alkaliu/CanLogger2CH_stm32/doc/protect_12v.png

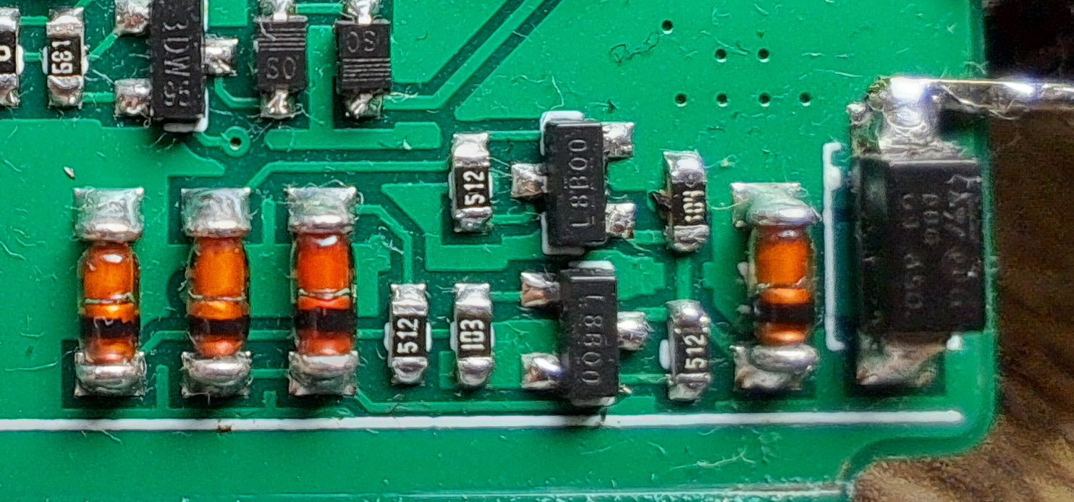
doc/protect_12v.png
