alkaliu/CanLogger2CH_stm32/doc/ap63205.png

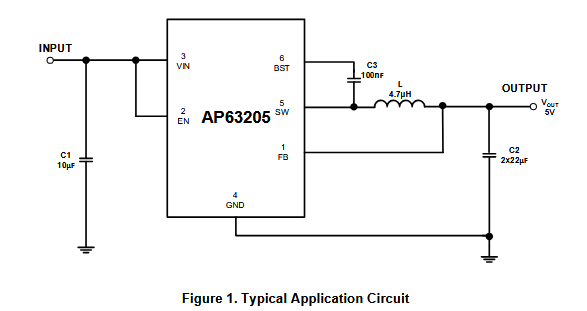
doc/ap63205.png
