alkaliu/CanLogger2CH_stm32/doc/STDC14.png

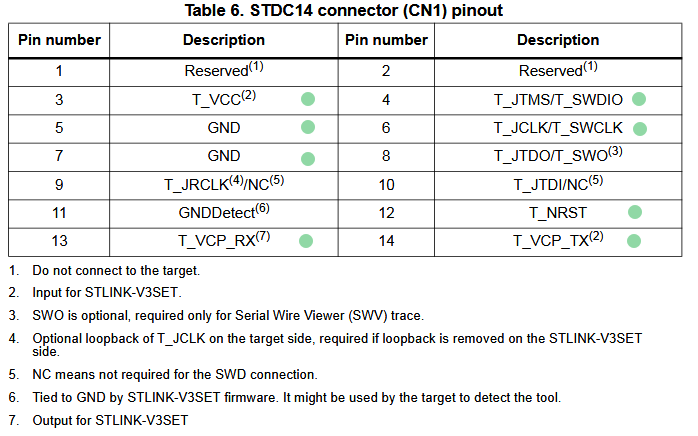
doc/STDC14.png
