alkaliu/CanLogger2CH_stm32/sch/EASYEDA_MODELS/FTSH-107-01-F-DV--3DModel-STEP-56544.STEP

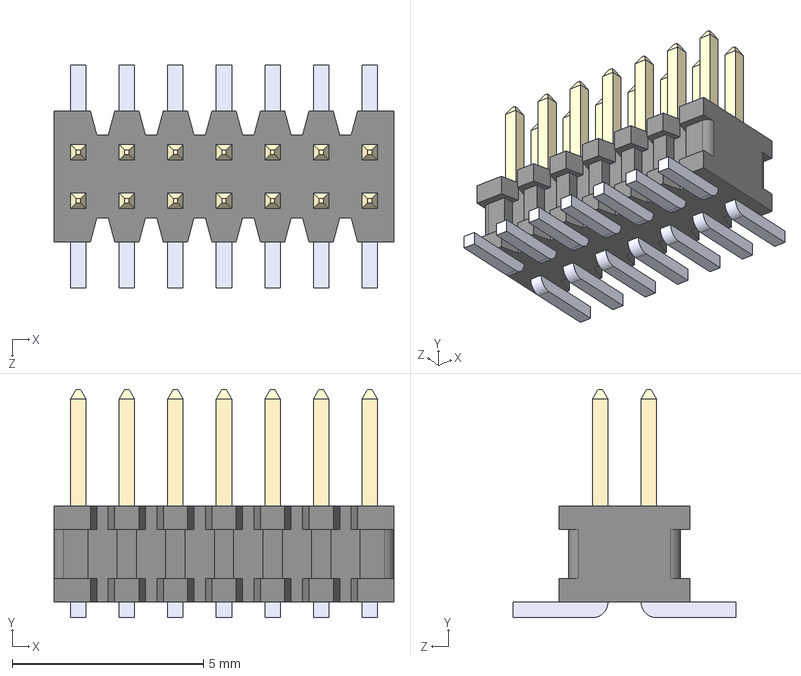
[picture p4: CAD file, 2025-10-31]
sch/EASYEDA_MODELS/FTSH-107-01-F-DV--3DModel-STEP-56544.STEP
8.89 x 5.97 x 5.84 mm
