alkaliu/CanLogger2CH_stm32/sch/EASYEDA_MODELS/CASE-A_3216.step

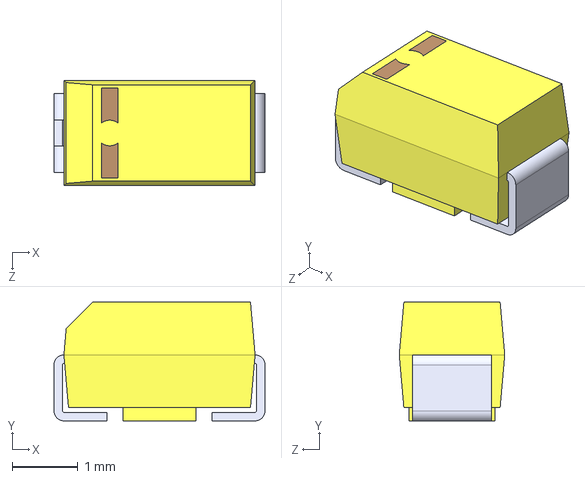
[picture p5: CAD file, 2025-10-31]
sch/EASYEDA_MODELS/CASE-A_3216.step
3.20 x 1.80 x 1.60 mm
