alkaliu/CanLogger2CH_stm32/sch/EASYEDA_MODELS/HDR2.54-M-LI-2x3P.step

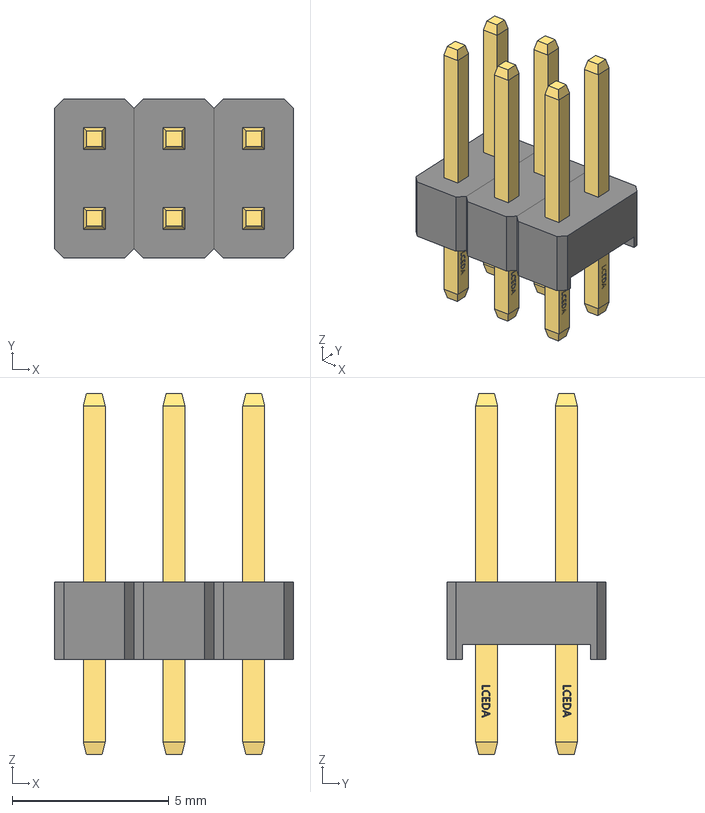
[picture p7: CAD file, 2025-10-31]
sch/EASYEDA_MODELS/HDR2.54-M-LI-2x3P.step
7.62 x 5.08 x 11.5 mm
