alkaliu/CanLogger2CH_stm32/sch/EASYEDA_MODELS/SMA_L4.3-W2.6-LS5.2-RD.step

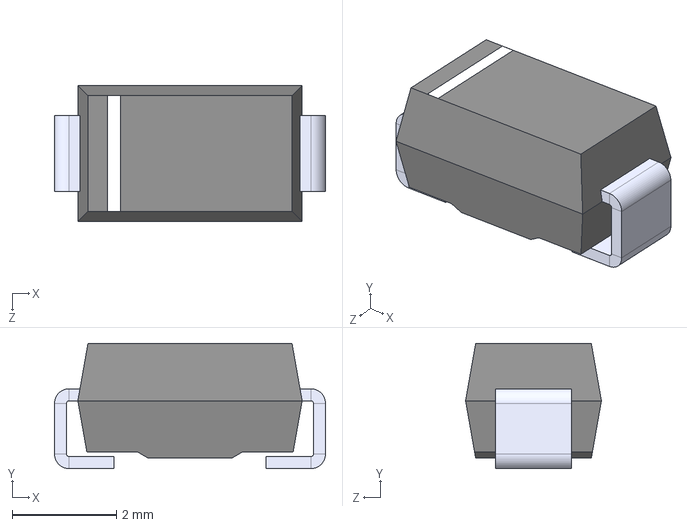
[picture p8: CAD file, 2025-10-31]
sch/EASYEDA_MODELS/SMA_L4.3-W2.6-LS5.2-RD.step
5.20 x 2.40 x 2.60 mm
