alkaliu/CanLogger2CH_stm32/sch/EASYEDA_MODELS/DLW31SN222SQ2L--3DModel-STEP-1.STEP

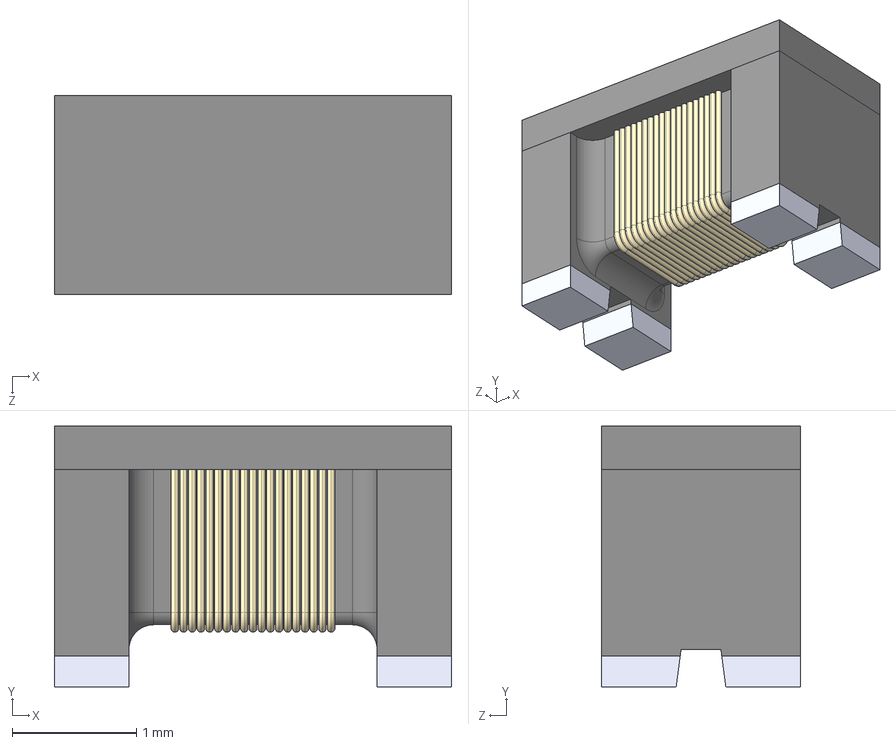
[picture p9: CAD file, 2025-10-31]
sch/EASYEDA_MODELS/DLW31SN222SQ2L--3DModel-STEP-1.STEP
3.20 x 2.10 x 1.60 mm
