alkaliu/CanLogger2CH_stm32/sch/EASYEDA_MODELS/C1206_L3.2-W1.6-H1.3.step

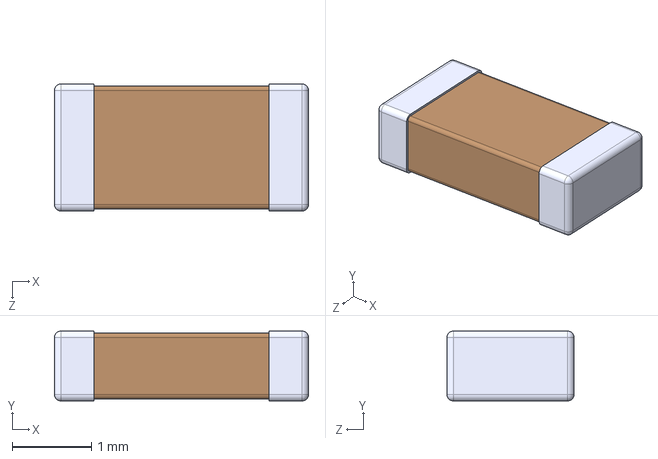
[picture p10: CAD file, 2025-10-31]
sch/EASYEDA_MODELS/C1206_L3.2-W1.6-H1.3.step
3.20 x 0.88 x 1.60 mm
