alkaliu/CanLogger2CH_stm32/sch/EASYEDA_MODELS/USB-C-SMD_GT-USB-7047A.step

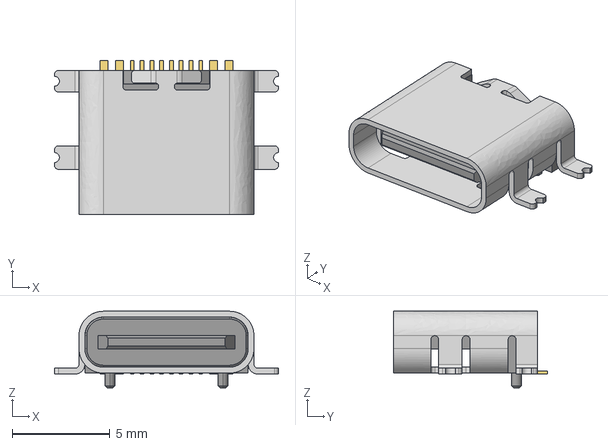
[picture p11: CAD file, 2025-10-31]
sch/EASYEDA_MODELS/USB-C-SMD_GT-USB-7047A.step
11.4 x 7.85 x 3.91 mm
