alkaliu/CanLogger2CH_stm32/sch/EASYEDA_MODELS/C0603_L1.6-W0.8-H0.8.step

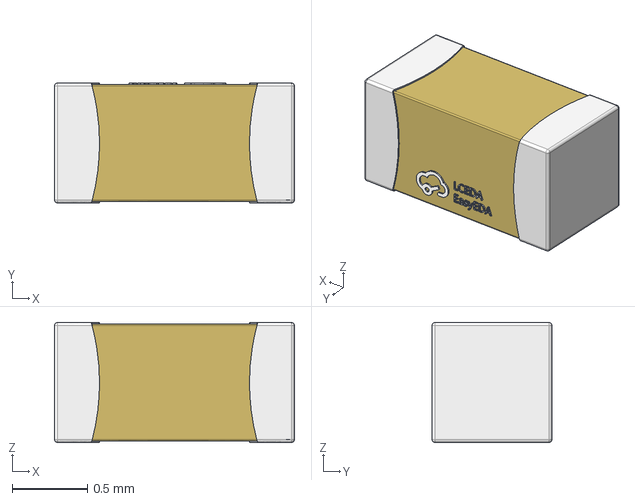
[picture p12: CAD file, 2025-10-31]
sch/EASYEDA_MODELS/C0603_L1.6-W0.8-H0.8.step
1.60 x 0.8 x 0.8 mm
