alkaliu/CanLogger2CH_stm32/sch/EASYEDA_MODELS/LED0603-RD.step

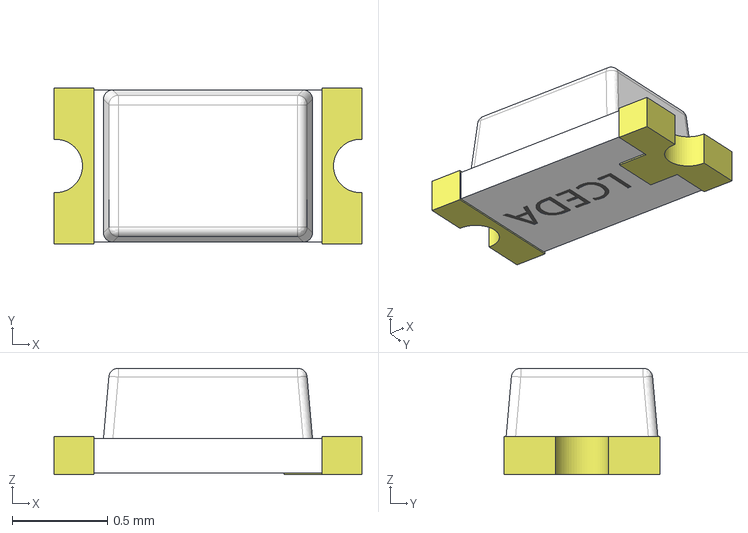
[picture p13: CAD file, 2025-10-31]
sch/EASYEDA_MODELS/LED0603-RD.step
1.62 x 0.82 x 0.56 mm
