alkaliu/CanLogger2CH_stm32/sch/EASYEDA_MODELS/F1812_L4.5-W3.2-H1.0.step

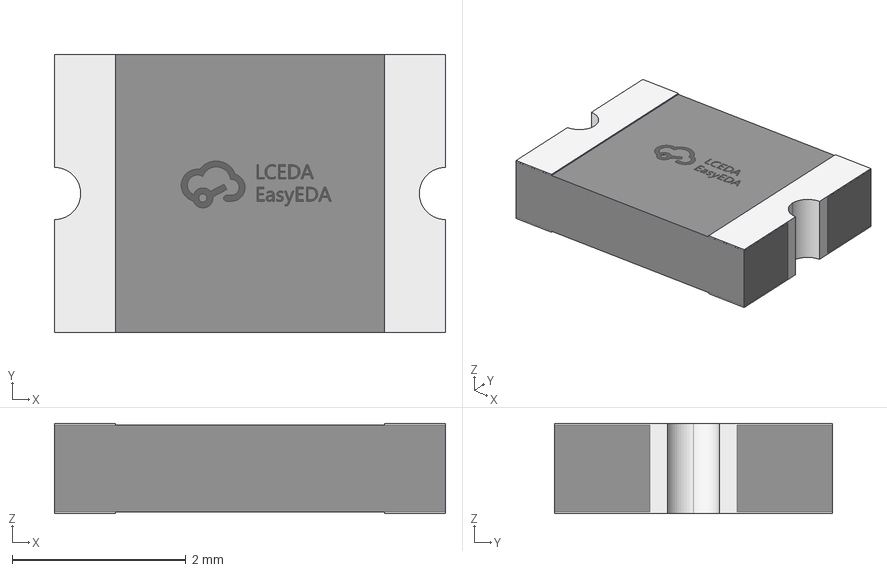
[picture p14: CAD file, 2025-10-31]
sch/EASYEDA_MODELS/F1812_L4.5-W3.2-H1.0.step
4.50 x 3.20 x 1.04 mm
