alkaliu/CanLogger2CH_stm32/sch/EASYEDA_MODELS/SW-SMD_L5.2-W5.2-H4.5-P3.70-LS6.4.step

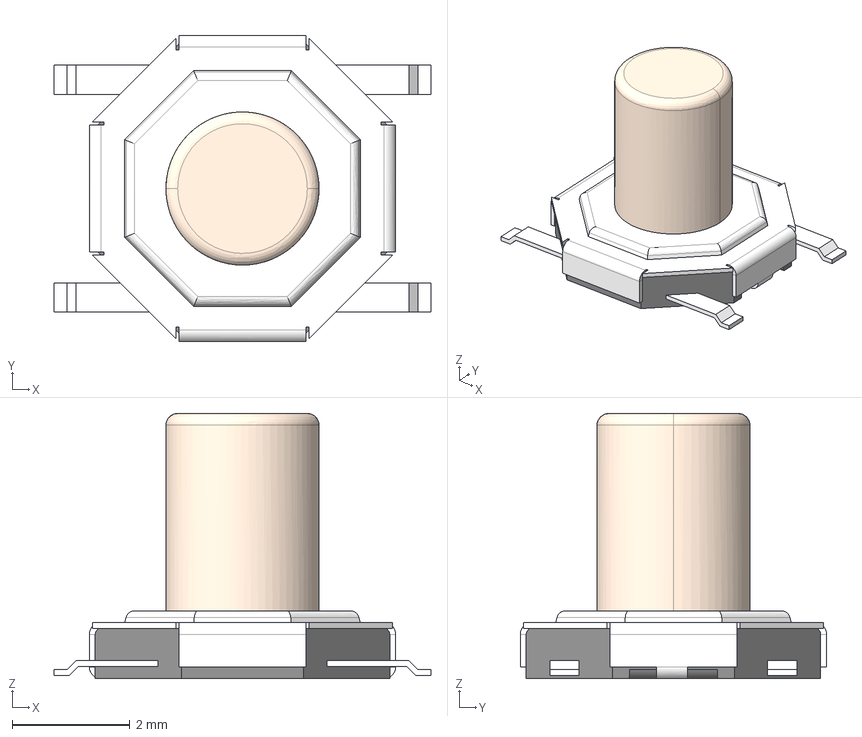
[picture p15: CAD file, 2025-10-31]
sch/EASYEDA_MODELS/SW-SMD_L5.2-W5.2-H4.5-P3.70-LS6.4.step
6.40 x 5.20 x 4.50 mm
