alkaliu/CanLogger2CH_stm32/sch/EASYEDA_MODELS/FILTER-SMD_4P-L3.2-W1.6-H1.9-BL_DLW31SN222SQ2L.step

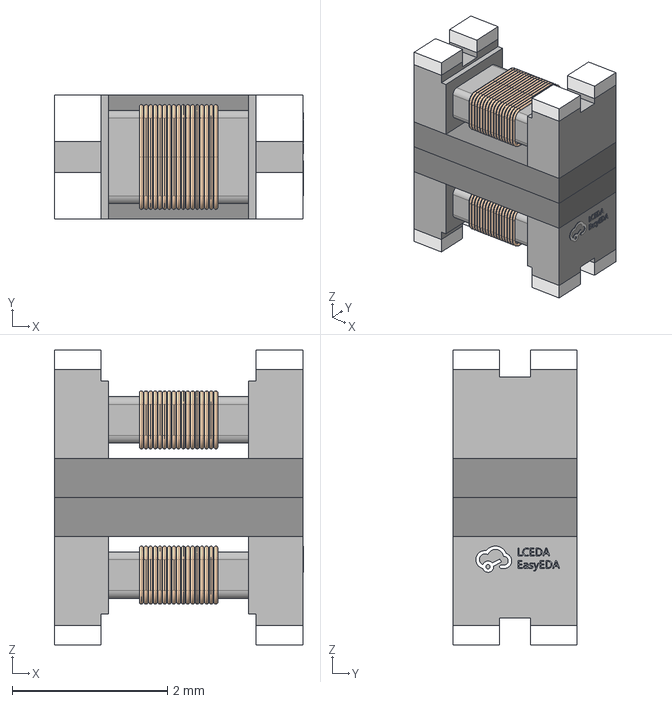
[picture p16: CAD file, 2025-10-31]
sch/EASYEDA_MODELS/FILTER-SMD_4P-L3.2-W1.6-H1.9-BL_DLW31SN222SQ2L.step
3.21 x 1.60 x 3.80 mm
