alkaliu/CanLogger2CH_stm32/sch/EASYEDA_MODELS/SOT-323-3_L2.0-W1.3-H1.0-LS2.1-P1.30.step

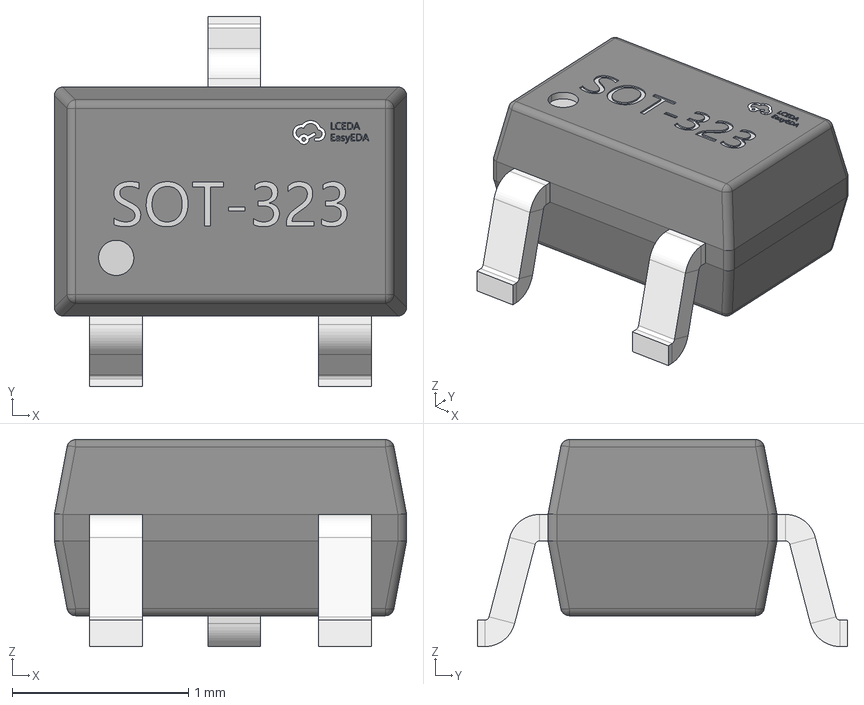
[picture p17: CAD file, 2025-10-31]
sch/EASYEDA_MODELS/SOT-323-3_L2.0-W1.3-H1.0-LS2.1-P1.30.step
2.00 x 2.10 x 1.18 mm
