alkaliu/CanLogger2CH_stm32/sch/EASYEDA_MODELS/SOT-23-3L_L2.9-W1.6-H1.1-LS2.8-P0.95.step

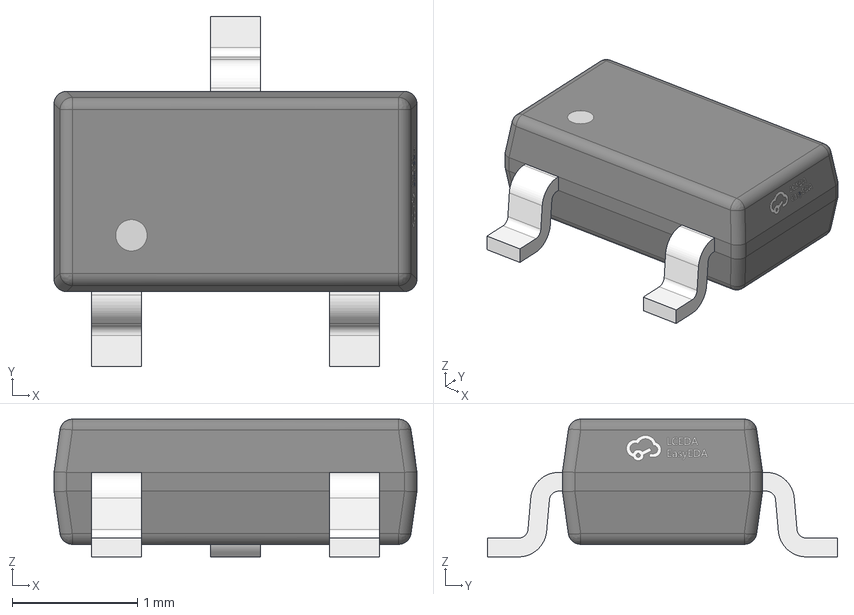
[picture p18: CAD file, 2025-10-31]
sch/EASYEDA_MODELS/SOT-23-3L_L2.9-W1.6-H1.1-LS2.8-P0.95.step
2.90 x 2.80 x 1.10 mm
