alkaliu/CanLogger2CH_stm32/sch/EASYEDA_MODELS/CRYSTAL-SMD_4P-L3.2-W2.5-BL_SIT8008BI.step

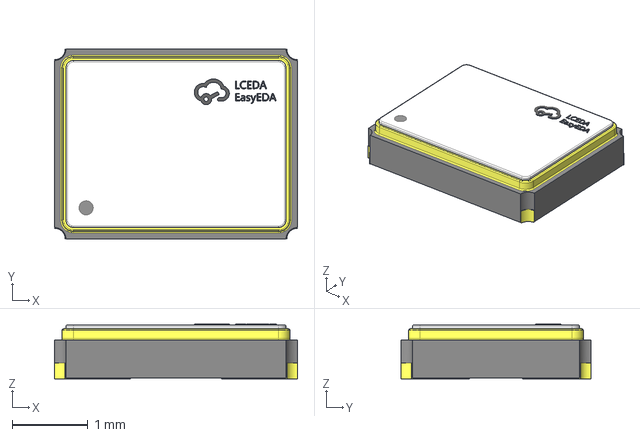
[picture p19: CAD file, 2025-10-31]
sch/EASYEDA_MODELS/CRYSTAL-SMD_4P-L3.2-W2.5-BL_SIT8008BI.step
3.20 x 2.50 x 0.72 mm
