alkaliu/CanLogger2CH_stm32/sch/EASYEDA_MODELS/IND-SMD_L4.4-W4.2-H1.2_PSPMAA0412.step

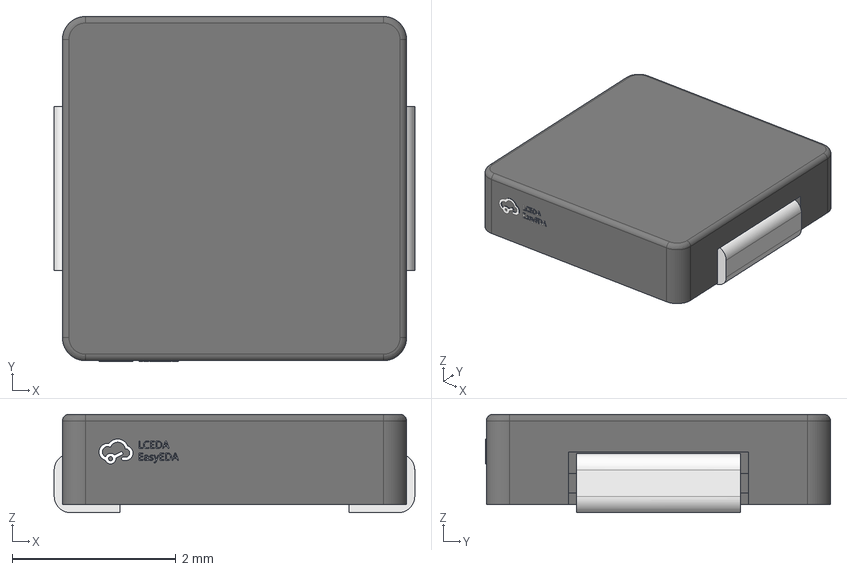
[picture p21: CAD file, 2025-10-31]
sch/EASYEDA_MODELS/IND-SMD_L4.4-W4.2-H1.2_PSPMAA0412.step
4.40 x 4.21 x 1.20 mm
