alkaliu/CanLogger2CH_stm32/sch/EASYEDA_MODELS/LED0805-RD_GREEN.step

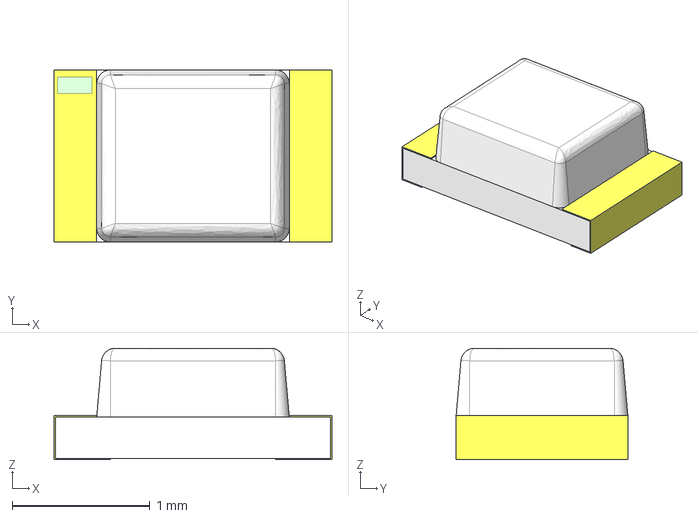
[picture p22: CAD file, 2025-10-31]
sch/EASYEDA_MODELS/LED0805-RD_GREEN.step
2.02 x 1.25 x 0.81 mm
