alkaliu/CanLogger2CH_stm32/sch/EASYEDA_MODELS/SMA_L4.4-W2.6-LS5.0-RD.step

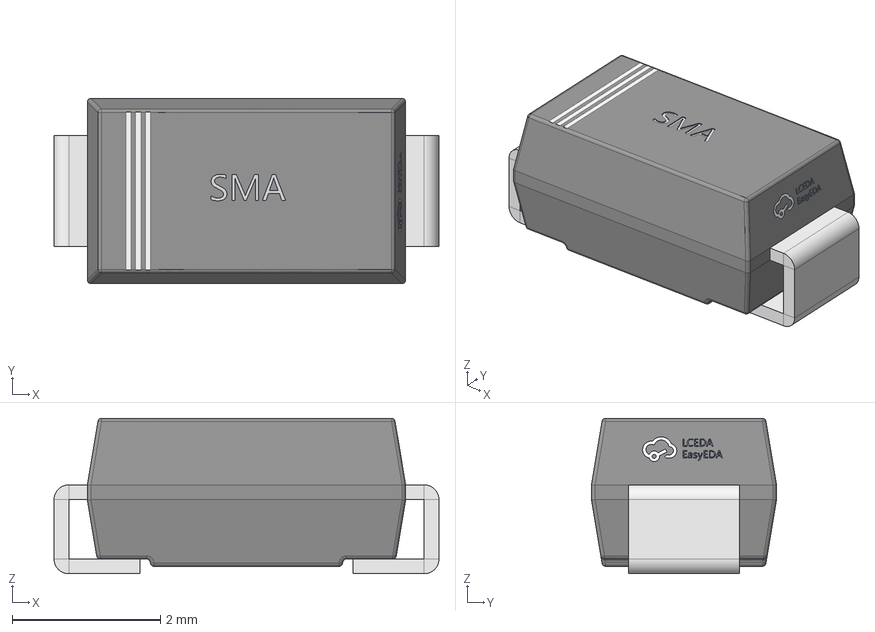
[picture p23: CAD file, 2025-10-31]
sch/EASYEDA_MODELS/SMA_L4.4-W2.6-LS5.0-RD.step
5.20 x 2.50 x 2.10 mm
