alkaliu/CanLogger2CH_stm32/sch/EASYEDA_MODELS/C0805_L2.0-W1.3-H1.3.step

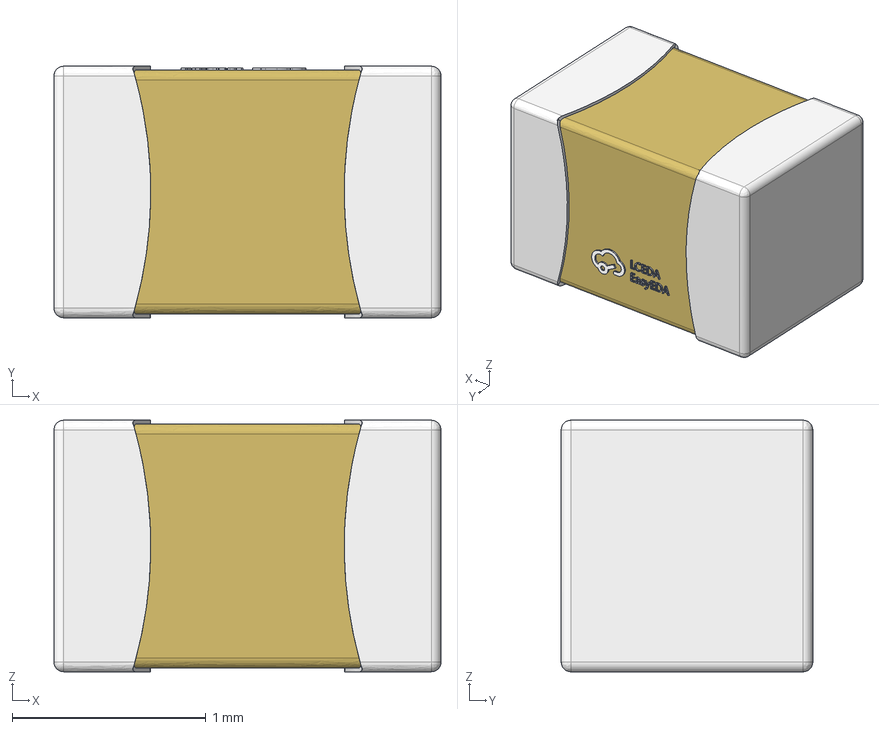
[picture p24: CAD file, 2025-10-31]
sch/EASYEDA_MODELS/C0805_L2.0-W1.3-H1.3.step
2.00 x 1.30 x 1.30 mm
