alkaliu/CanLogger2CH_stm32/sch/EASYEDA_MODELS/DSUB-TH_DMR-9P-M-LI.step

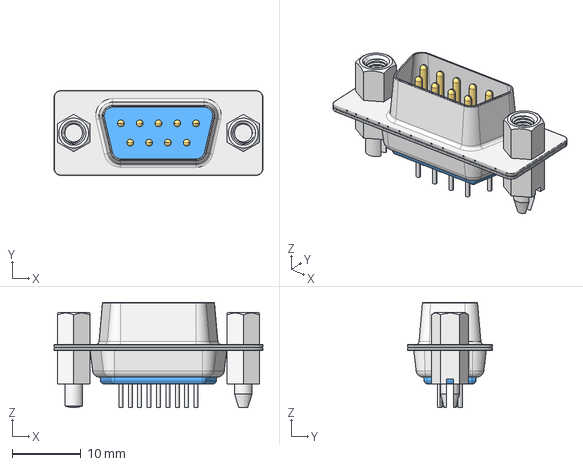
[picture p26: CAD file, 2025-10-31]
sch/EASYEDA_MODELS/DSUB-TH_DMR-9P-M-LI.step
30.4 x 12.3 x 15.3 mm
