alkaliu/CanLogger2CH_stm32/sch/EASYEDA_MODELS/USB-C-SMD_GT-USB-7010C.step

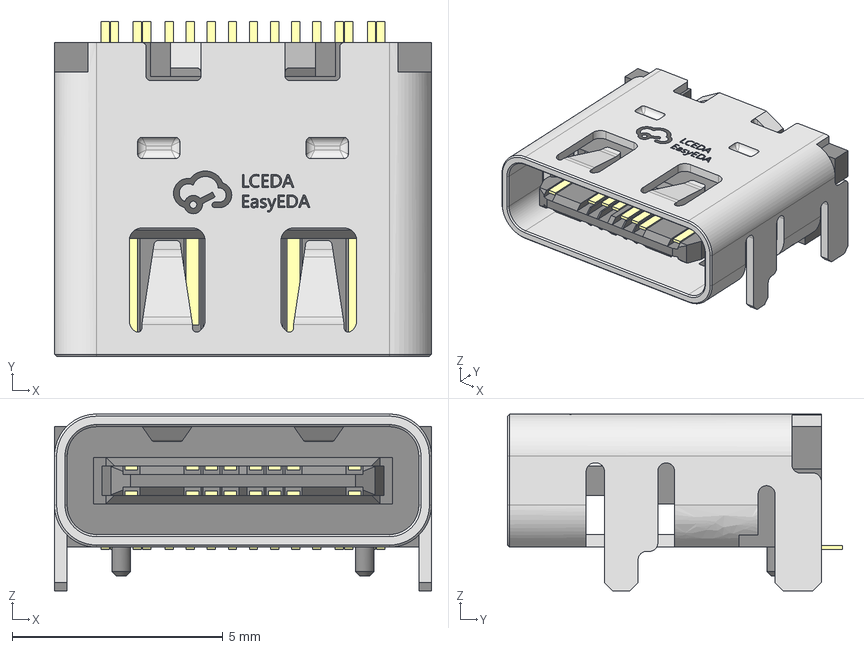
[picture p27: CAD file, 2025-10-31]
sch/EASYEDA_MODELS/USB-C-SMD_GT-USB-7010C.step
8.95 x 7.95 x 4.20 mm
