alkaliu/CanLogger2CH_stm32/sch/EASYEDA_MODELS/R1206_L3.2-W1.6-H0.6.step

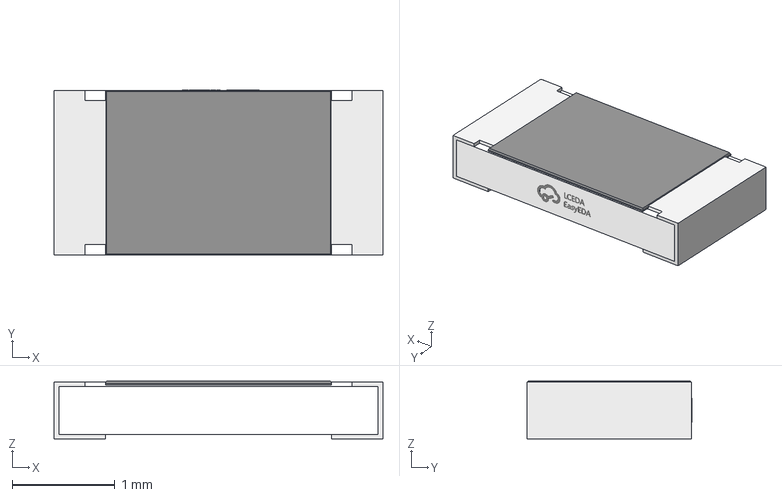
[picture p28: CAD file, 2025-10-31]
sch/EASYEDA_MODELS/R1206_L3.2-W1.6-H0.6.step
3.20 x 1.60 x 0.56 mm
