alkaliu/CanLogger2CH_stm32/sch/EASYEDA_MODELS/SOT-23-3P_L2.9-W1.3-H1.0-LS2.4-P0.95.step

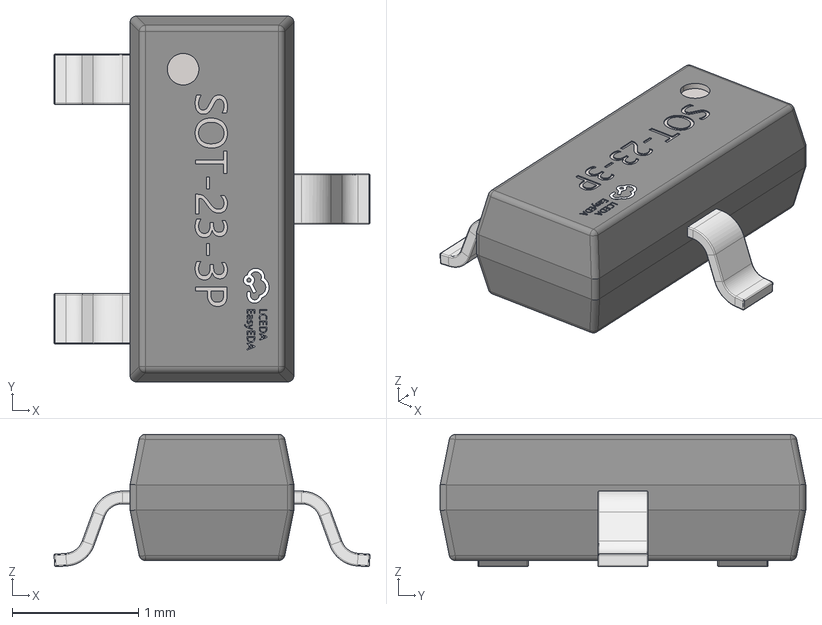
[picture p29: CAD file, 2025-10-31]
sch/EASYEDA_MODELS/SOT-23-3P_L2.9-W1.3-H1.0-LS2.4-P0.95.step
2.51 x 2.90 x 1.05 mm
