alkaliu/CanLogger2CH_stm32/sch/EASYEDA_MODELS/SOD-323_L1.8-W1.3-LS2.5-RD.step

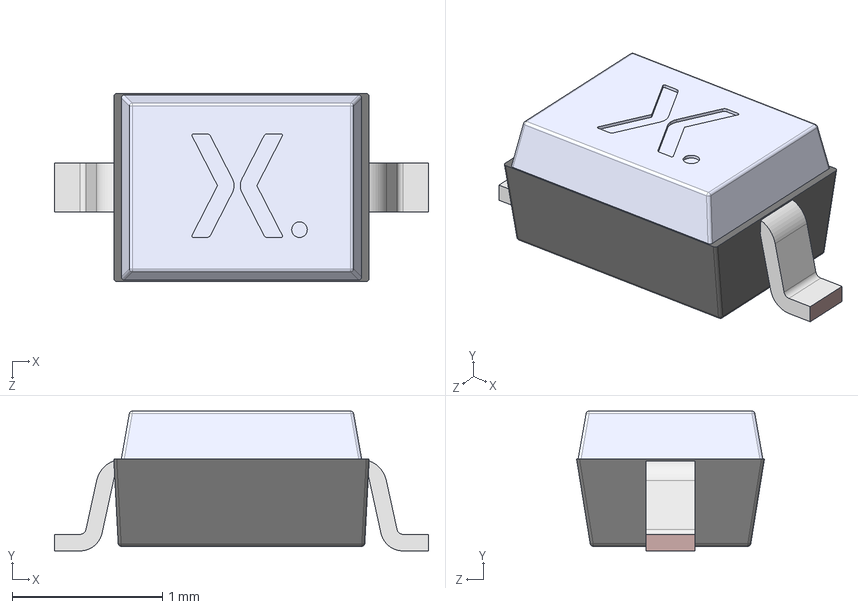
[picture p30: CAD file, 2025-10-31]
sch/EASYEDA_MODELS/SOD-323_L1.8-W1.3-LS2.5-RD.step
2.49 x 0.93 x 1.25 mm
SOD323 Lower body
SOD323 Lead x 2
SOD323 Upper body
