alkaliu/CanLogger2CH_stm32/sch/EASYEDA_MODELS/TO-252-2L-3P_L6.6-W6.1-H2.3-LS10.1-P4.6.step

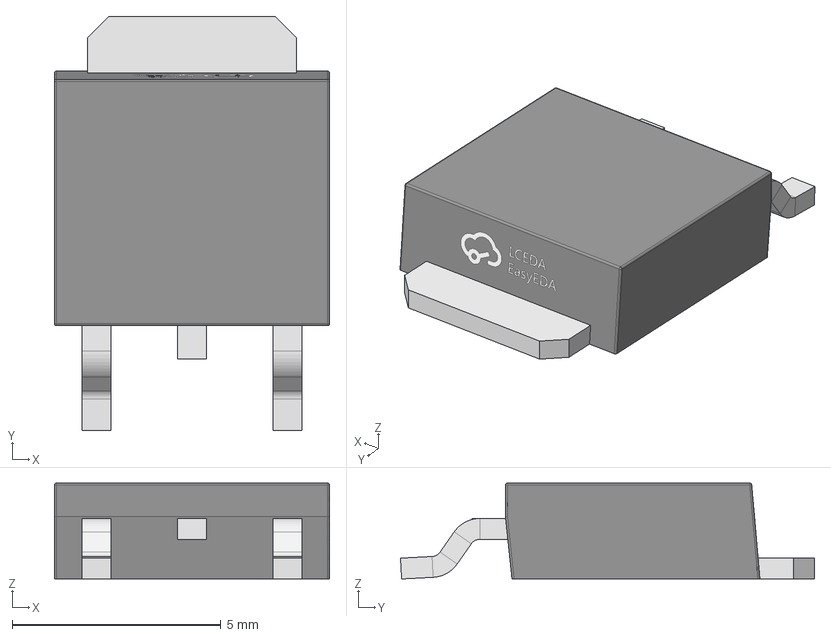
[picture p31: CAD file, 2025-10-31]
sch/EASYEDA_MODELS/TO-252-2L-3P_L6.6-W6.1-H2.3-LS10.1-P4.6.step
6.60 x 9.92 x 2.30 mm
