alkaliu/CanLogger2CH_stm32/sch/EASYEDA_MODELS/SOD-123_L2.8-W1.8-LS3.7-RD.step

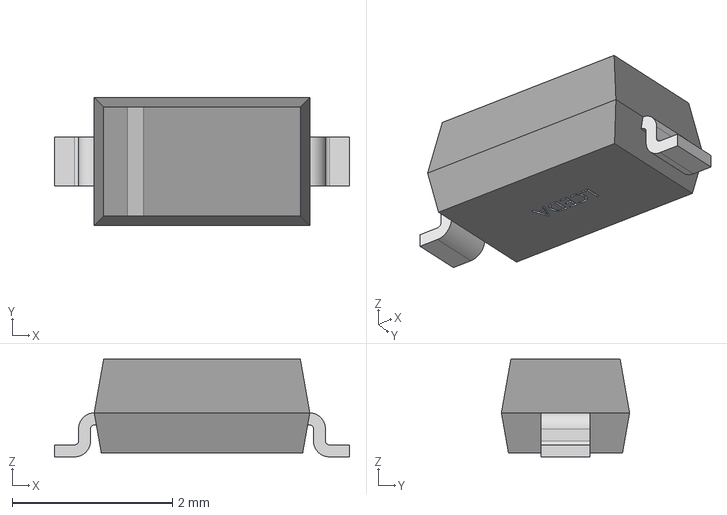
[picture p32: CAD file, 2025-10-31]
sch/EASYEDA_MODELS/SOD-123_L2.8-W1.8-LS3.7-RD.step
3.68 x 1.60 x 1.22 mm
