alkaliu/CanLogger2CH_stm32/sch/EASYEDA_MODELS/SOP-8_L4.9-W3.9-P1.27-LS6.0-BL-1.step

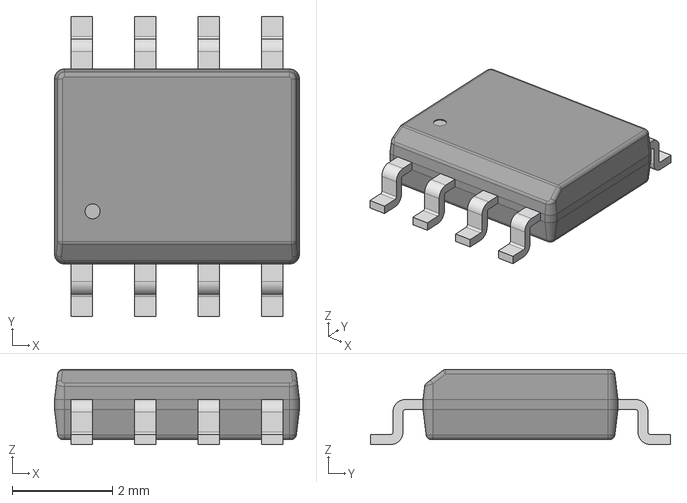
[picture p33: CAD file, 2025-10-31]
sch/EASYEDA_MODELS/SOP-8_L4.9-W3.9-P1.27-LS6.0-BL-1.step
4.90 x 6.00 x 1.50 mm
