alkaliu/CanLogger2CH_stm32/sch/EASYEDA_MODELS/SIM-SMD_GT-TF003-H0185-02.step

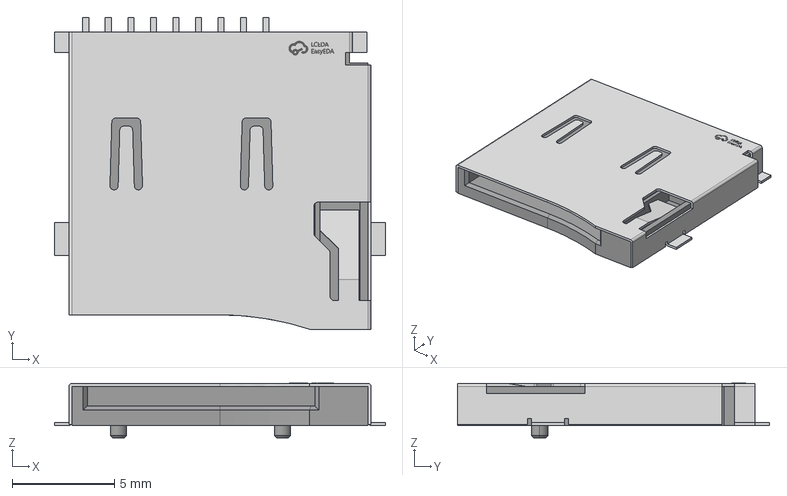
[picture p34: CAD file, 2025-10-31]
sch/EASYEDA_MODELS/SIM-SMD_GT-TF003-H0185-02.step
16.1 x 15.2 x 2.66 mm
