alkaliu/CanLogger2CH_stm32/sch/EASYEDA_MODELS/R0603.step

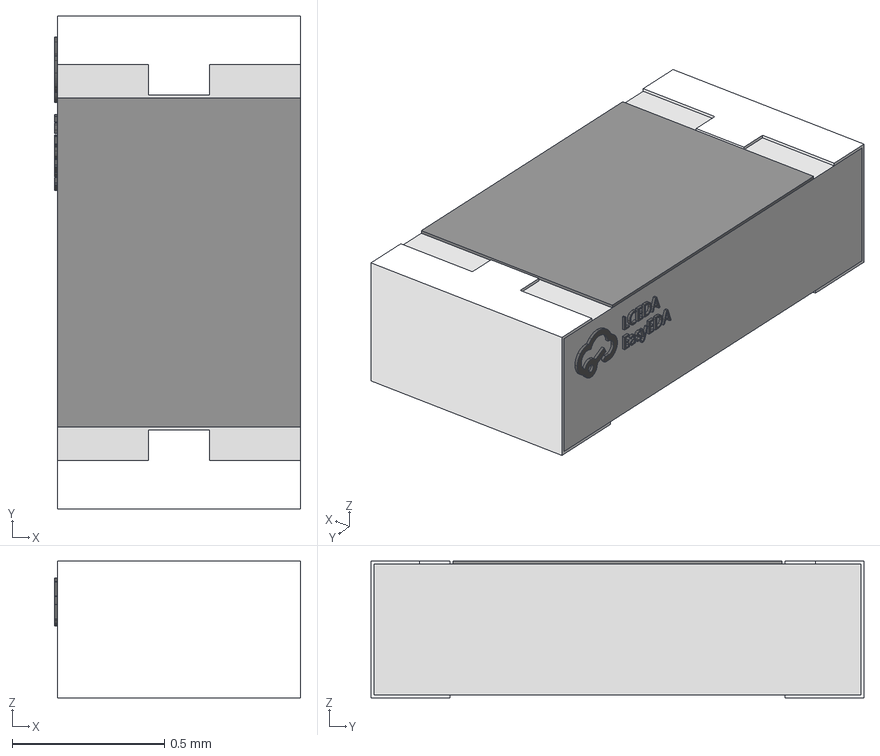
[picture p35: CAD file, 2025-10-31]
sch/EASYEDA_MODELS/R0603.step
0.81 x 1.62 x 0.45 mm
