alkaliu/CanLogger2CH_stm32/sch/EASYEDA_MODELS/SOIC-8_L4.9-W3.9-H1.7-LS6.0-P1.27.step

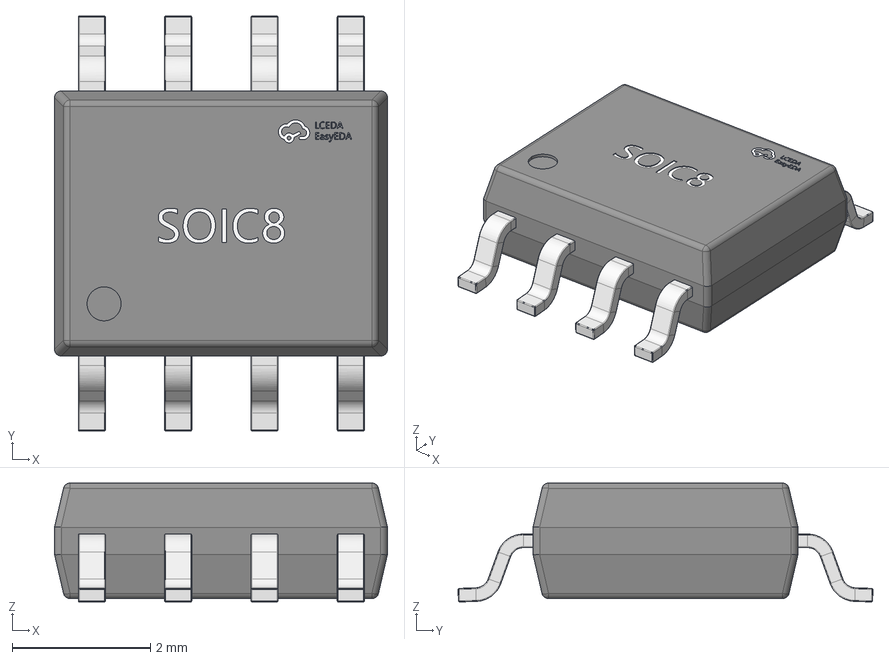
[picture p36: CAD file, 2025-10-31]
sch/EASYEDA_MODELS/SOIC-8_L4.9-W3.9-H1.7-LS6.0-P1.27.step
4.82 x 6.00 x 1.72 mm
