alkaliu/CanLogger2CH_stm32/sch/v1.0_order/canlogger_pcb.pdf

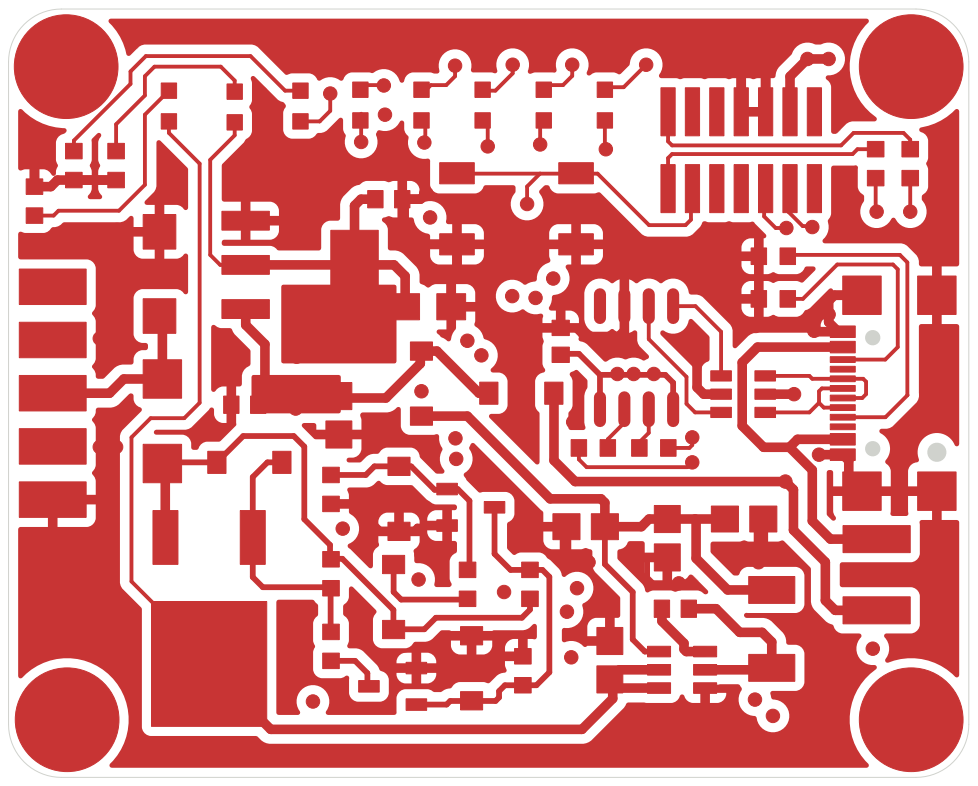
[picture p37: page 1]

Id: 1/8 Title: File: canlogger.kicad_pcb Sheet:

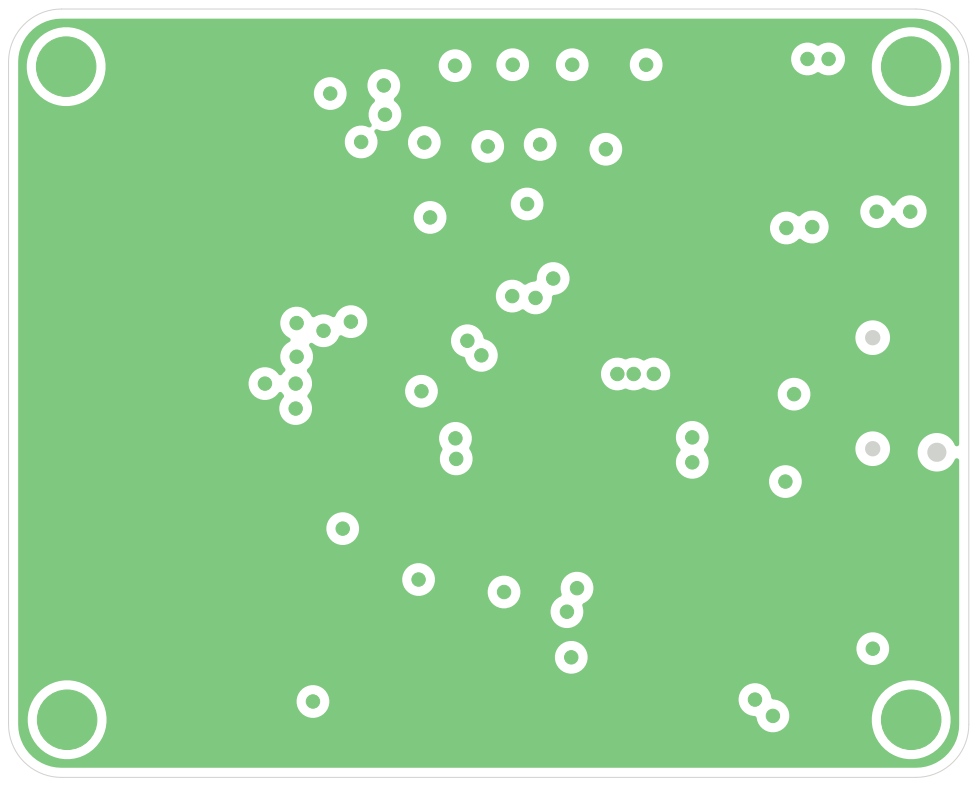
[picture p38: page 2]

Id: 2/8 Title: File: canlogger.kicad_pcb Sheet:

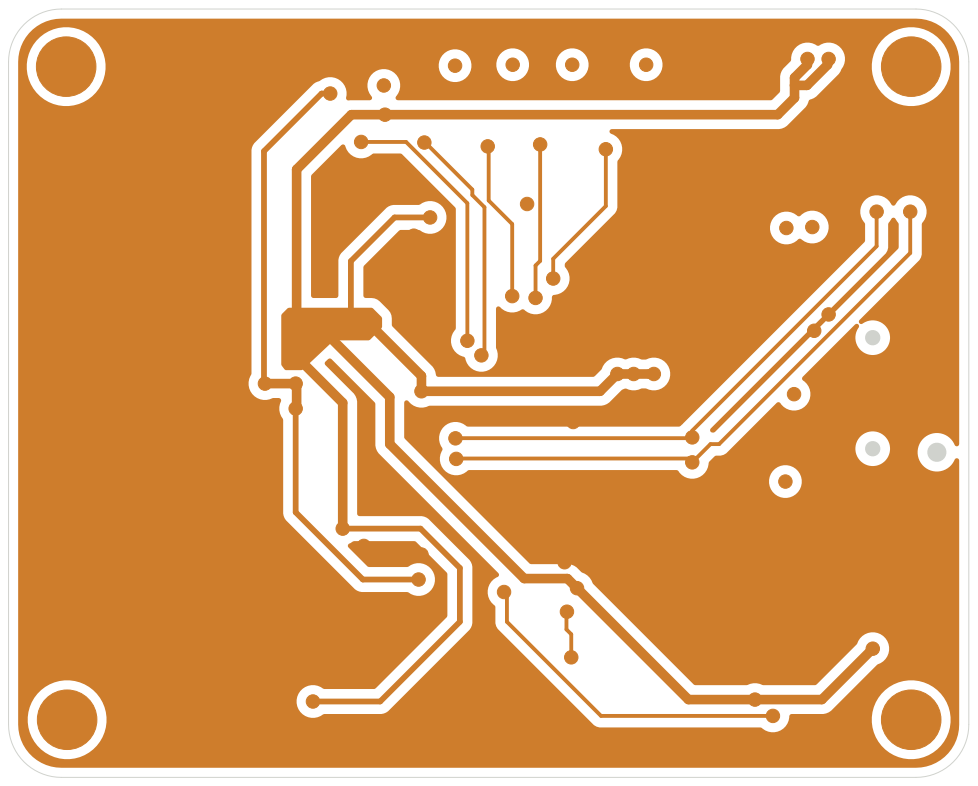
[picture p39: page 3]

Id: 3/8 Title: File: canlogger.kicad_pcb Sheet:

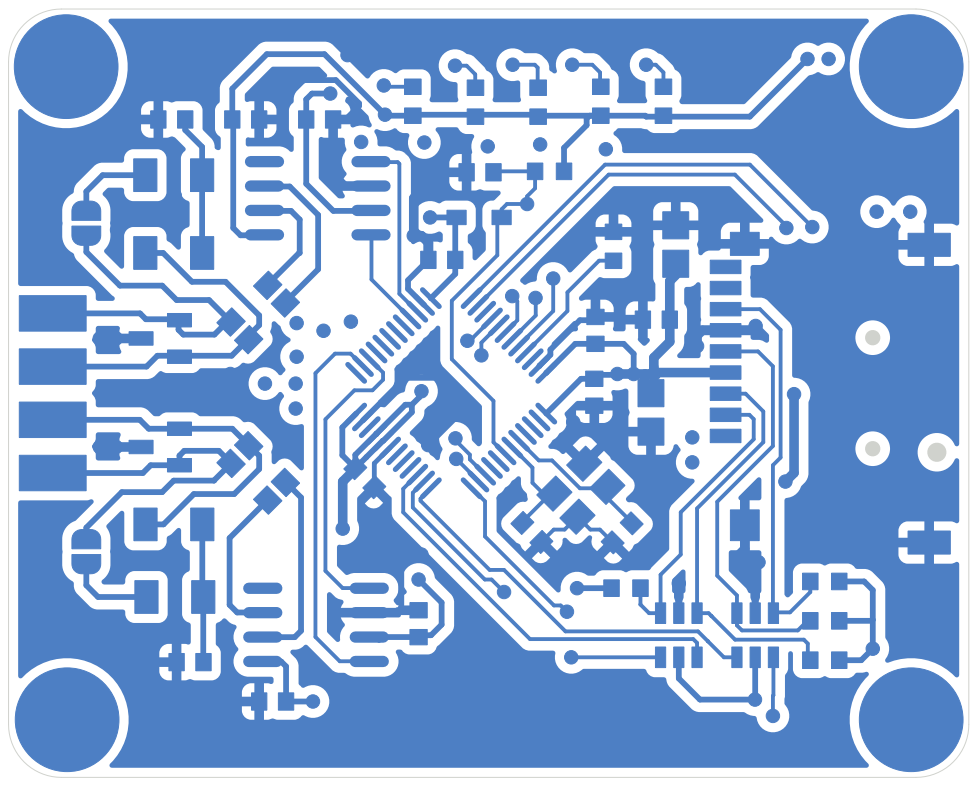
[picture p40: page 4]

Id: 4/8 Title: File: canlogger.kicad_pcb Sheet:

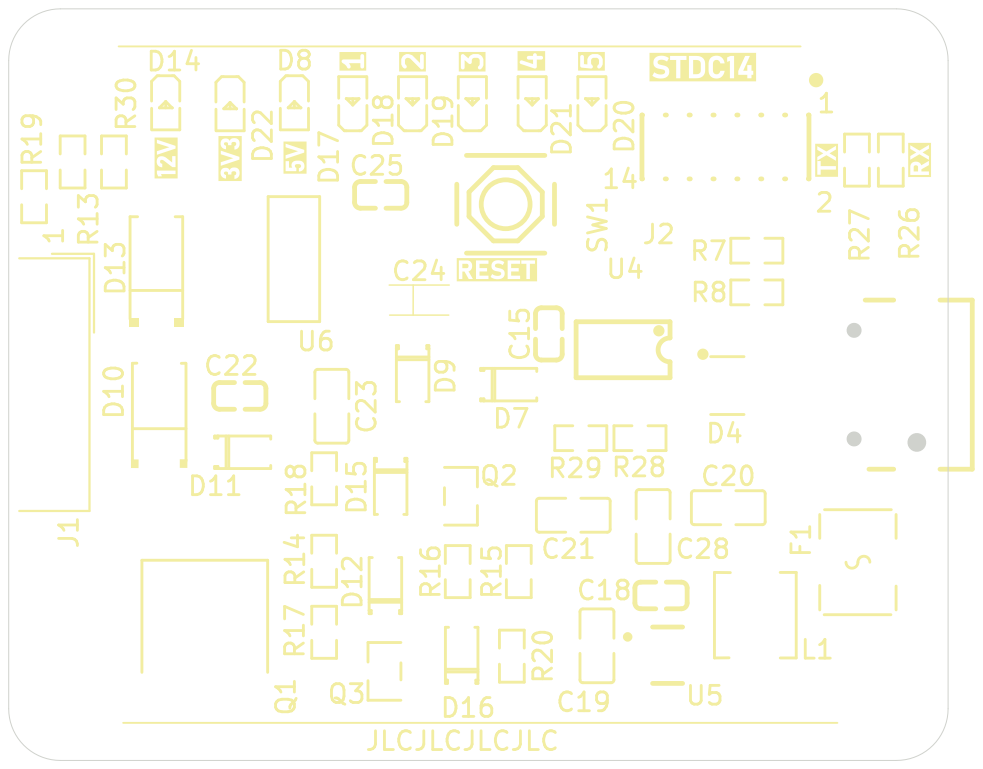
[picture p41: page 5]

Id: 5/8 Title: File: canlogger.kicad_pcb Sheet:

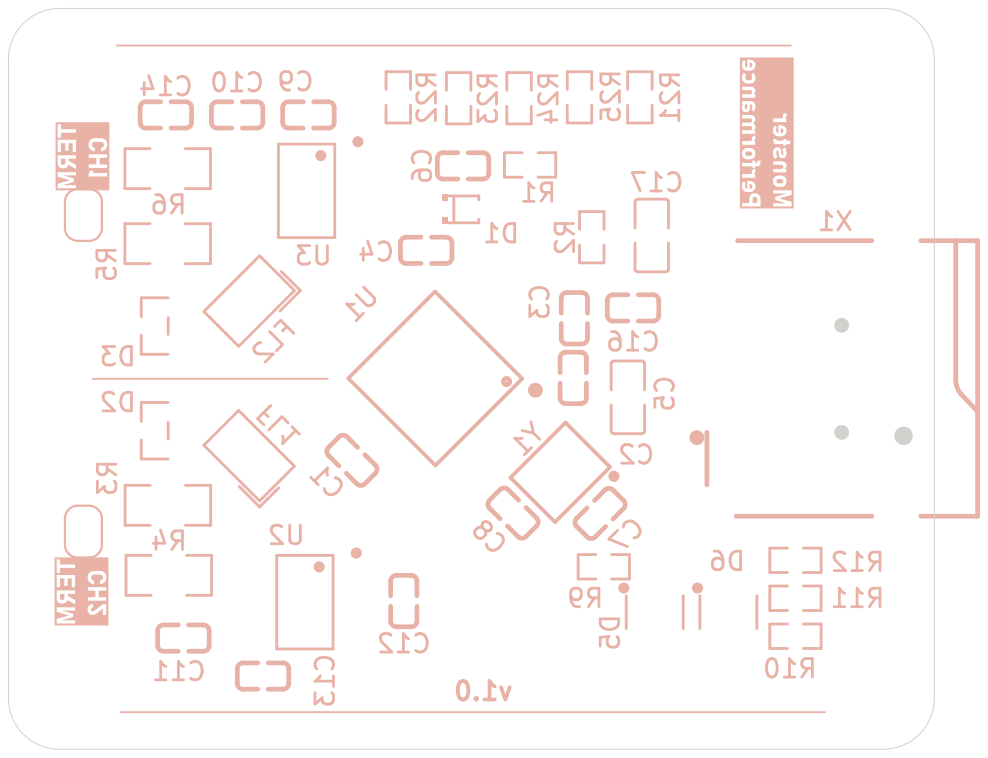
[picture p42: page 6]

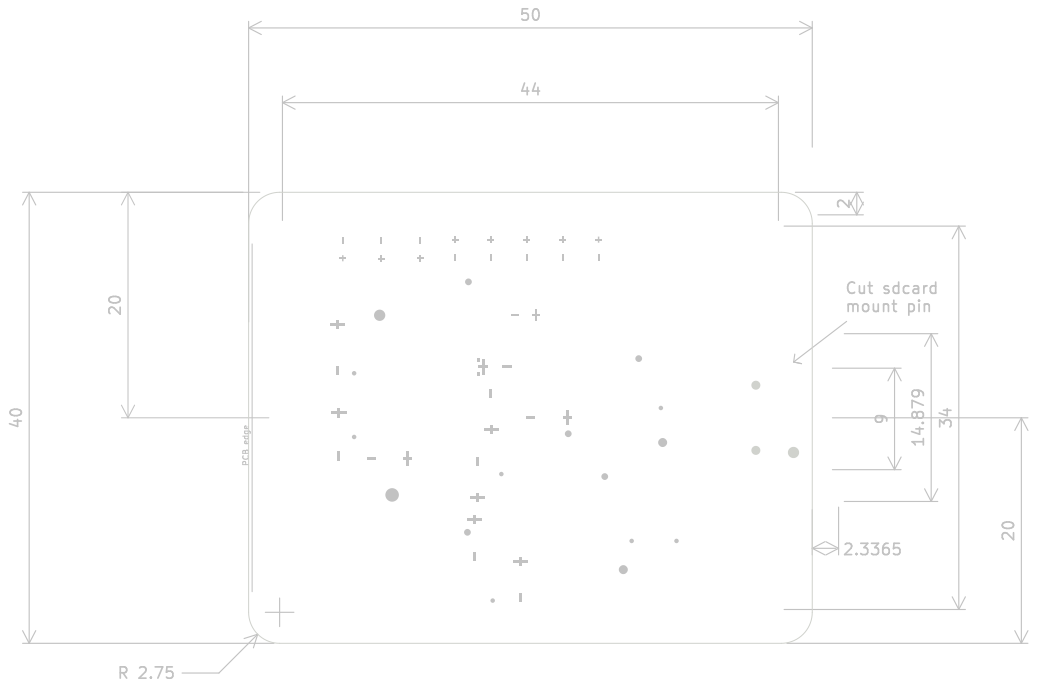
[picture p43: page 7]

Id: 7/8 Title: File: canlogger.kicad_pcb Sheet:

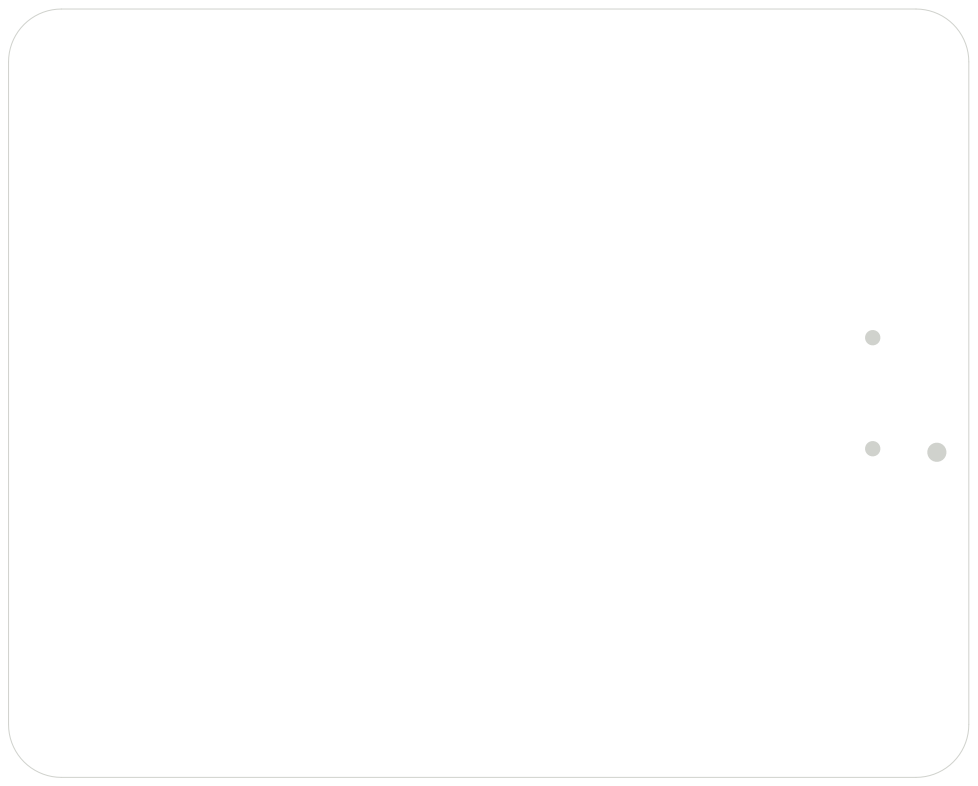
[picture p44: page 8]

Id: 8/8 Title: File: canlogger.kicad_pcb Sheet:
