alkaliu/CanLogger2CH_stm32/sch/v1.0_order/canlogger_sch.pdf

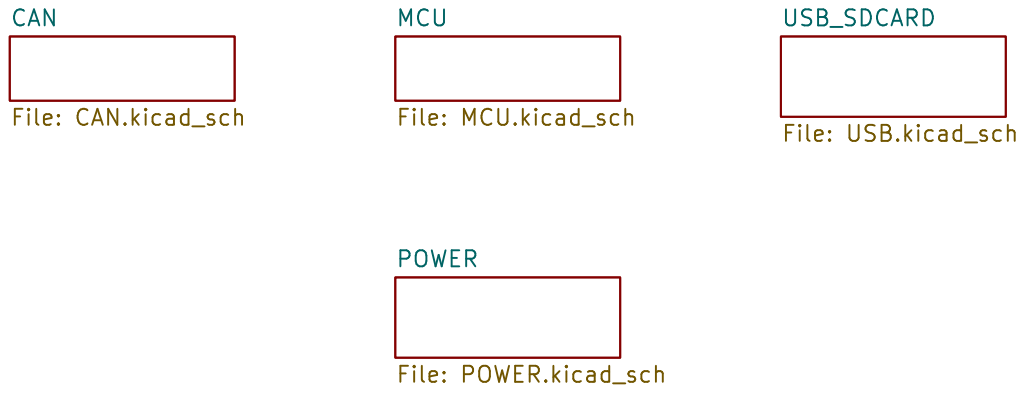
[picture p45: page 1]

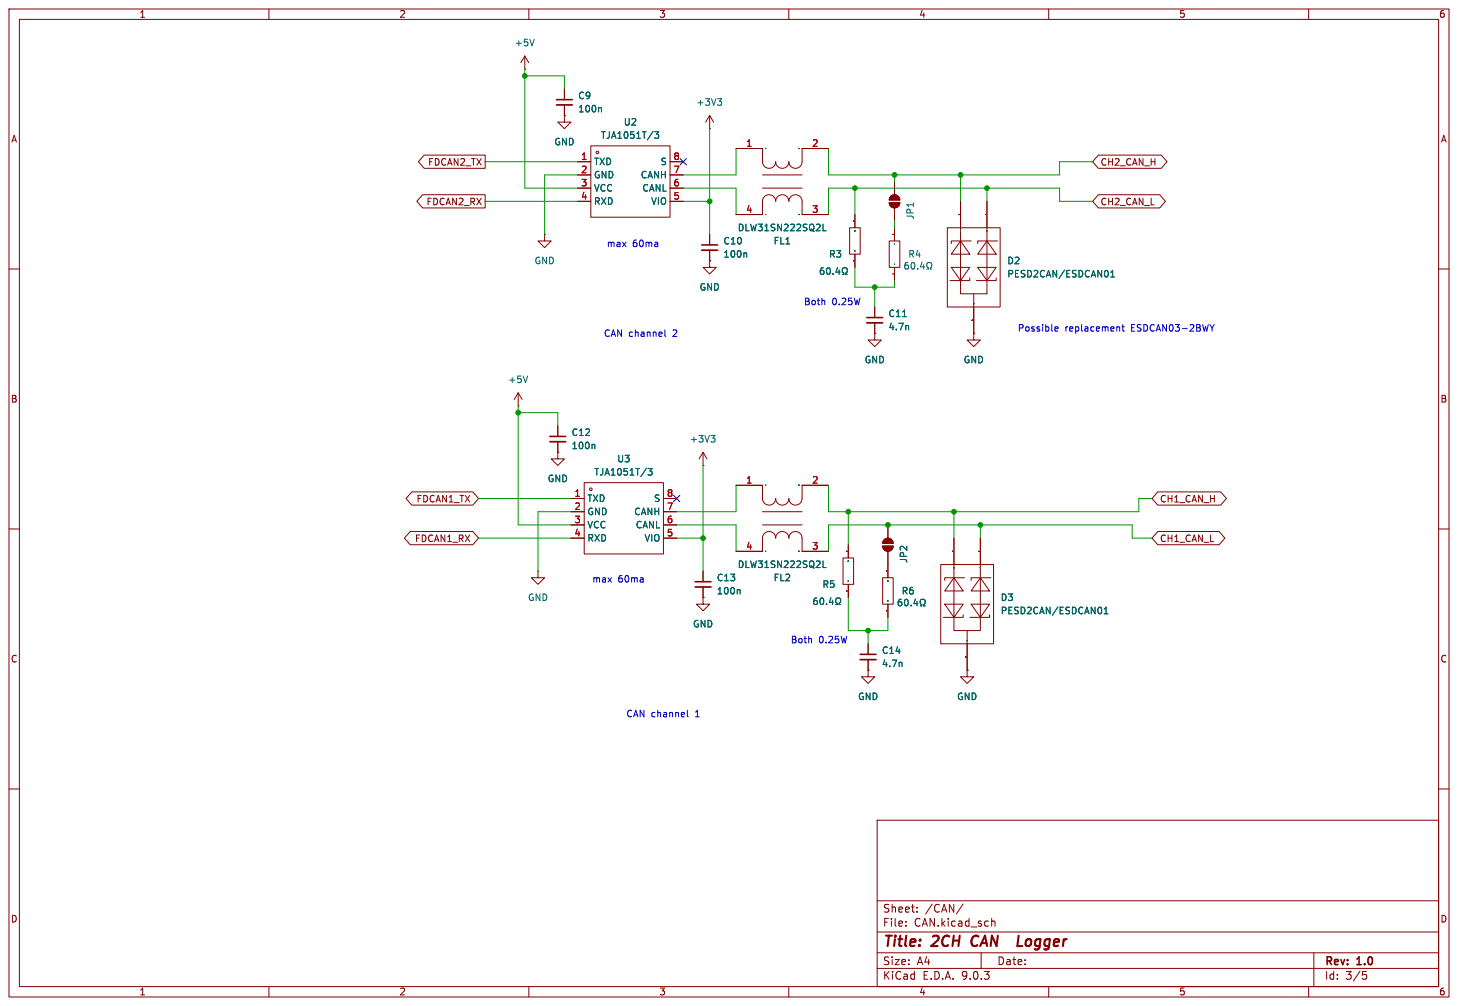
[picture p46: page 2]

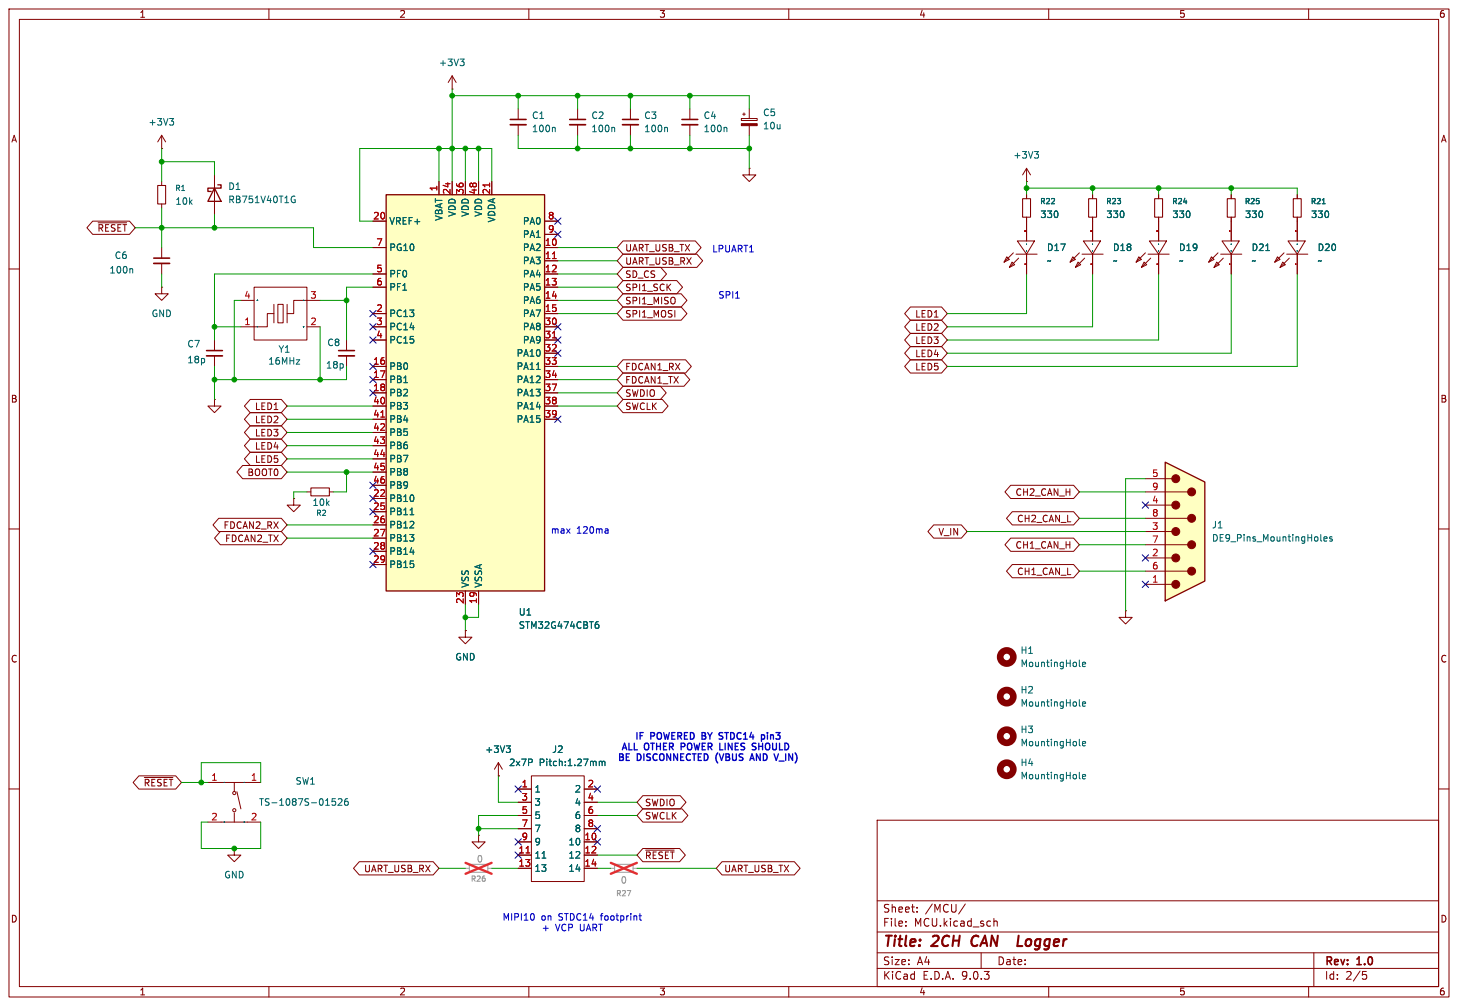
[picture p47: page 3]

1 VDD 24 VDD 36 VSS 23 VDD 48 VSSA 19 VDDA 21 PA0 8 PA1 9 PA2 10 PA3 11 PA4 12 PA5 13 PA6 14 PA7 15 PA8 30 PA9 31 PA10 32 PA11 33 PA12 34 PA13 37 PA14 38 PA15 39 U1STM32G474CBT6 R270

1 VDD 24 VDD 36 VSS 23 VDD 48 VSSA 19 VDDA 21 PA0 8 PA1 9 PA2 10 PA3 11 PA4 12 PA5 13 PA6 14 PA7 15 PA8 30 PA9 31 PA10 32 PA11 33 PA12 34 PA13 37 PA14 38 PA15 39 +3V3 J2

CH2_CAN_L MIPI10 on STDC14 footprint + VCP UART

BE DISCONNECTED (VBUS AND V_IN) max 120ma

IF POWERED BY STDC14 pin3 ALL OTHER POWER LINES SHOULD

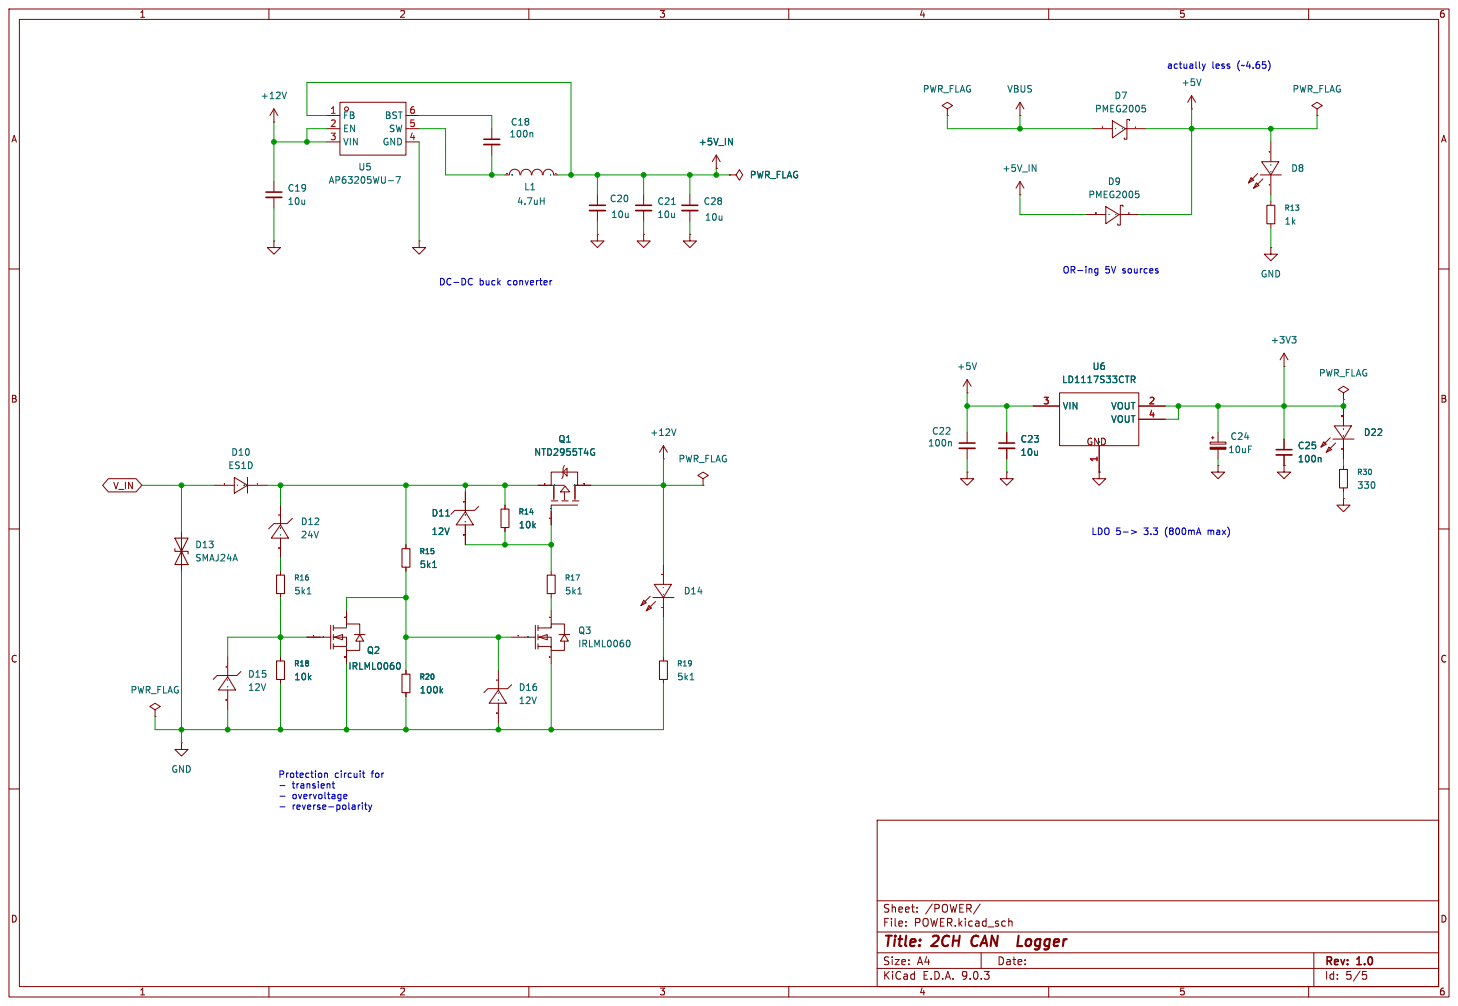
[picture p48: page 4]

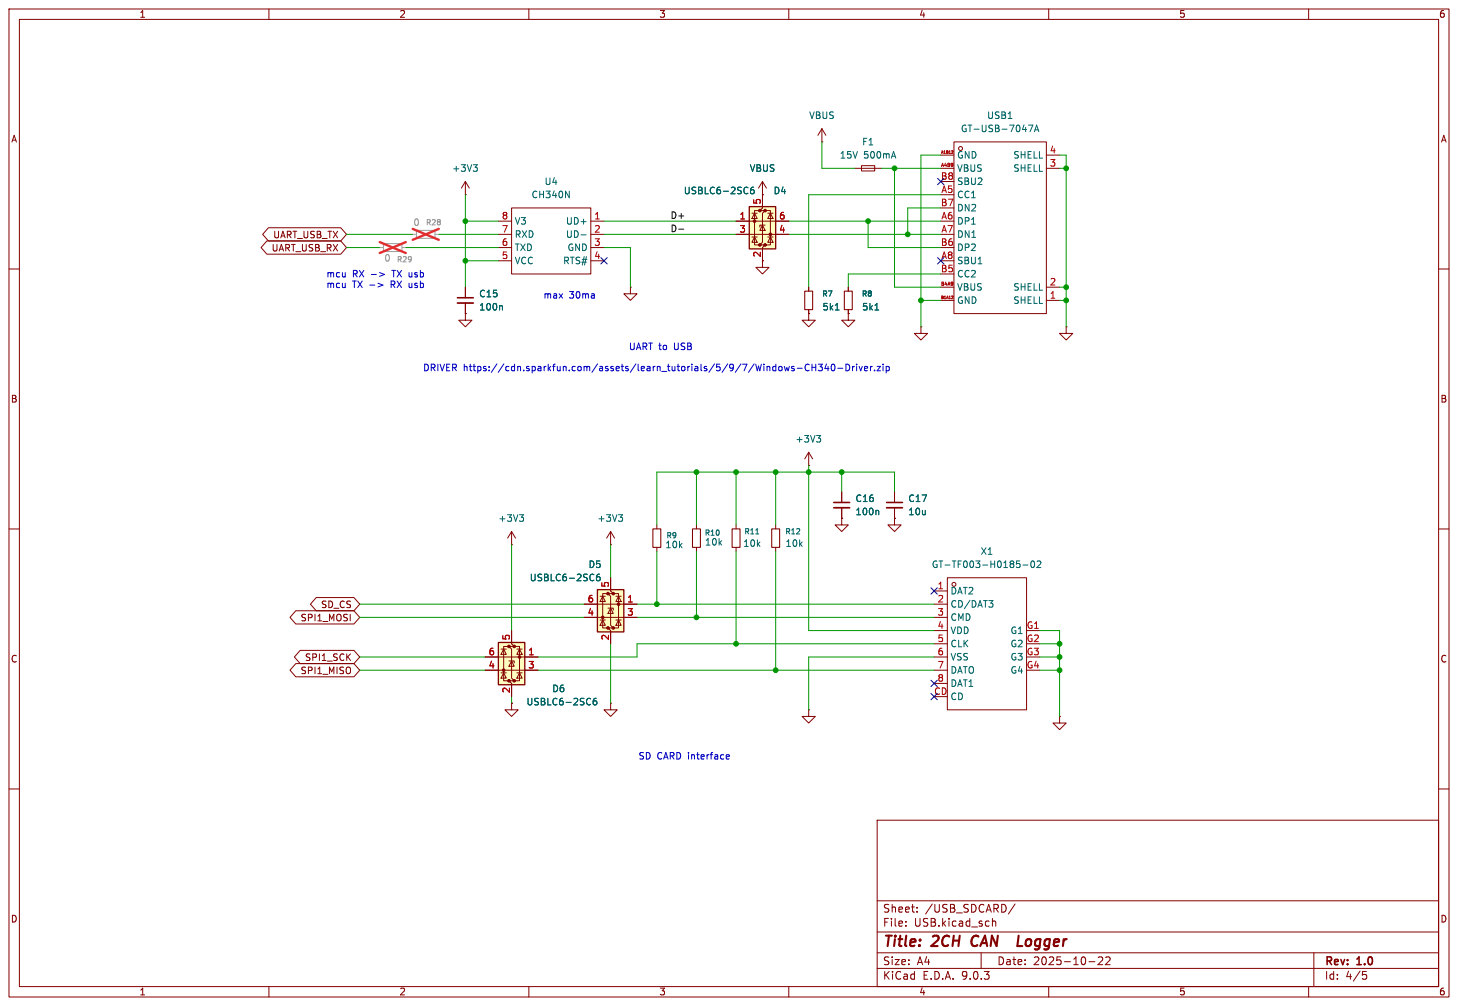
[picture p49: page 5]
