alkaliu/CanLogger2CH_stm32/sch/canlogger.kicad_pcb

## KiCad design sch/canlogger.kicad_pcb (2025-11-03)

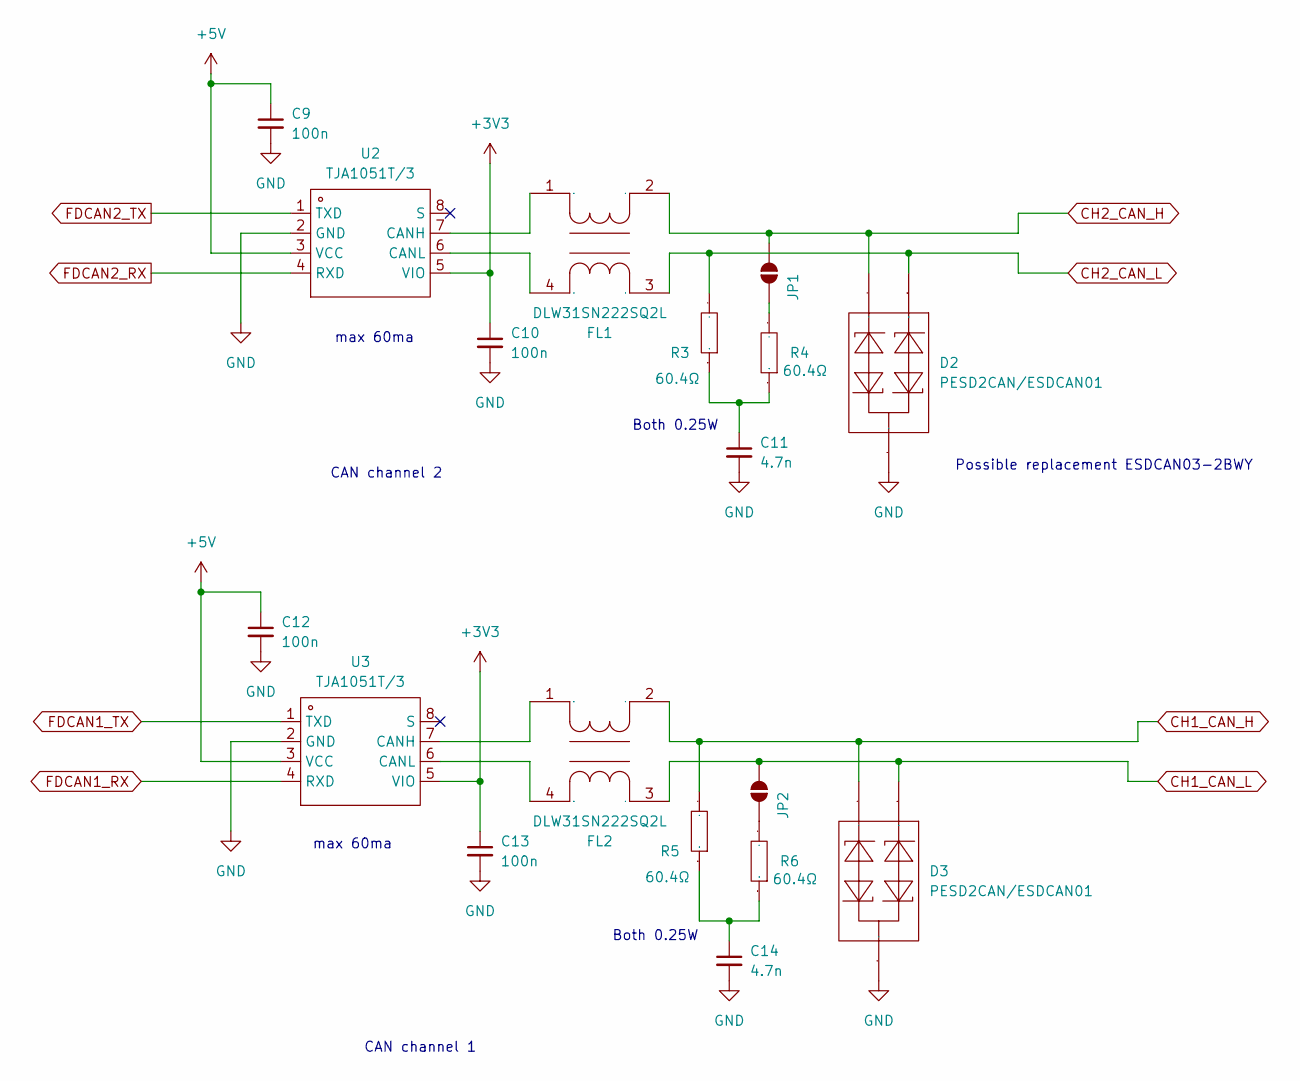
[picture p50: schematic CAN.kicad_sch, 2CH CAN Logger]

Parts:
C9, C10, C12, C13: 100n; C0603
C11, C14: 4.7n; C0603
D2, D3: PESD2CAN/ESDCAN01; SOT-23-3_L2.9-W1.3-P1.90-LS2.4-BR; Manufacturer Part PESD2CAN,215; LCSC Part Name 双向ESD 24V截止 峰值脉冲电流：5A@8/20us
FL1, FL2: DLW31SN222SQ2L; FILTER-SMD_4P-L3.2-W1.6-BL_DLW31SN222SQ2L; Manufacturer Part DLW31SN222SQ2L; LCSC Part Name 两路 贴片共模滤波器 阻抗2.2kΩ@100MHz
JP1, JP2: SolderJumper_2_Open; SolderJumper-2_P1.3mm_Open_RoundedPad1.0x1.5mm
R3, R4, R5, R6: 60.4Ω; R1206; Manufacturer Part 1206W4F604JT5E; LCSC Part Name 60.4Ω ±1% 250mW 厚膜电阻
U2, U3: TJA1051T/3; SOIC-8_L4.9-W3.9-P1.27-LS6.0-BL; Manufacturer Part TJA1051T/3/1J; LCSC Part Name TJA1051T/3/1J

Connections:
+3V3: C10.1, C13.1, U2.5 (VIO), U3.5 (VIO); also elsewhere on the board
+5V: C9.1, C12.1, U2.3 (VCC), U3.3 (VCC); also elsewhere on the board
CH1_CAN_H: D3.2, FL2.2, R5.2; also elsewhere on the board
CH1_CAN_L: D3.1, FL2.3, JP2.2 (B); also elsewhere on the board
CH2_CAN_H: D2.2, FL1.2, JP1.2 (B); also elsewhere on the board
CH2_CAN_L: D2.1, FL1.3, R3.2; also elsewhere on the board
FDCAN1_RX: U3.4 (RXD); also elsewhere on the board
FDCAN1_TX: U3.1 (TXD); also elsewhere on the board
FDCAN2_RX: U2.4 (RXD); also elsewhere on the board
FDCAN2_TX: U2.1 (TXD); also elsewhere on the board
GND: C9.2, C10.2, C11.2, C12.2, C13.2, C14.2, D2.3, D3.3, U2.2 (GND), U3.2 (GND); also elsewhere on the board
unnamed: C11.1, R3.1, R4.1
unnamed: C14.1, R5.1, R6.1
unnamed: JP1.1 (A), R4.2
unnamed: JP2.1 (A), R6.2
unnamed: FL1.1, U2.7 (CANH)
unnamed: FL1.4, U2.6 (CANL)
unnamed: FL2.1, U3.7 (CANH)
unnamed: FL2.4, U3.6 (CANL)

Notes on the sheet:
Both 0.25W
max 60ma
CAN channel 2
Possible replacement ESDCAN03-2BWY
CAN channel 1

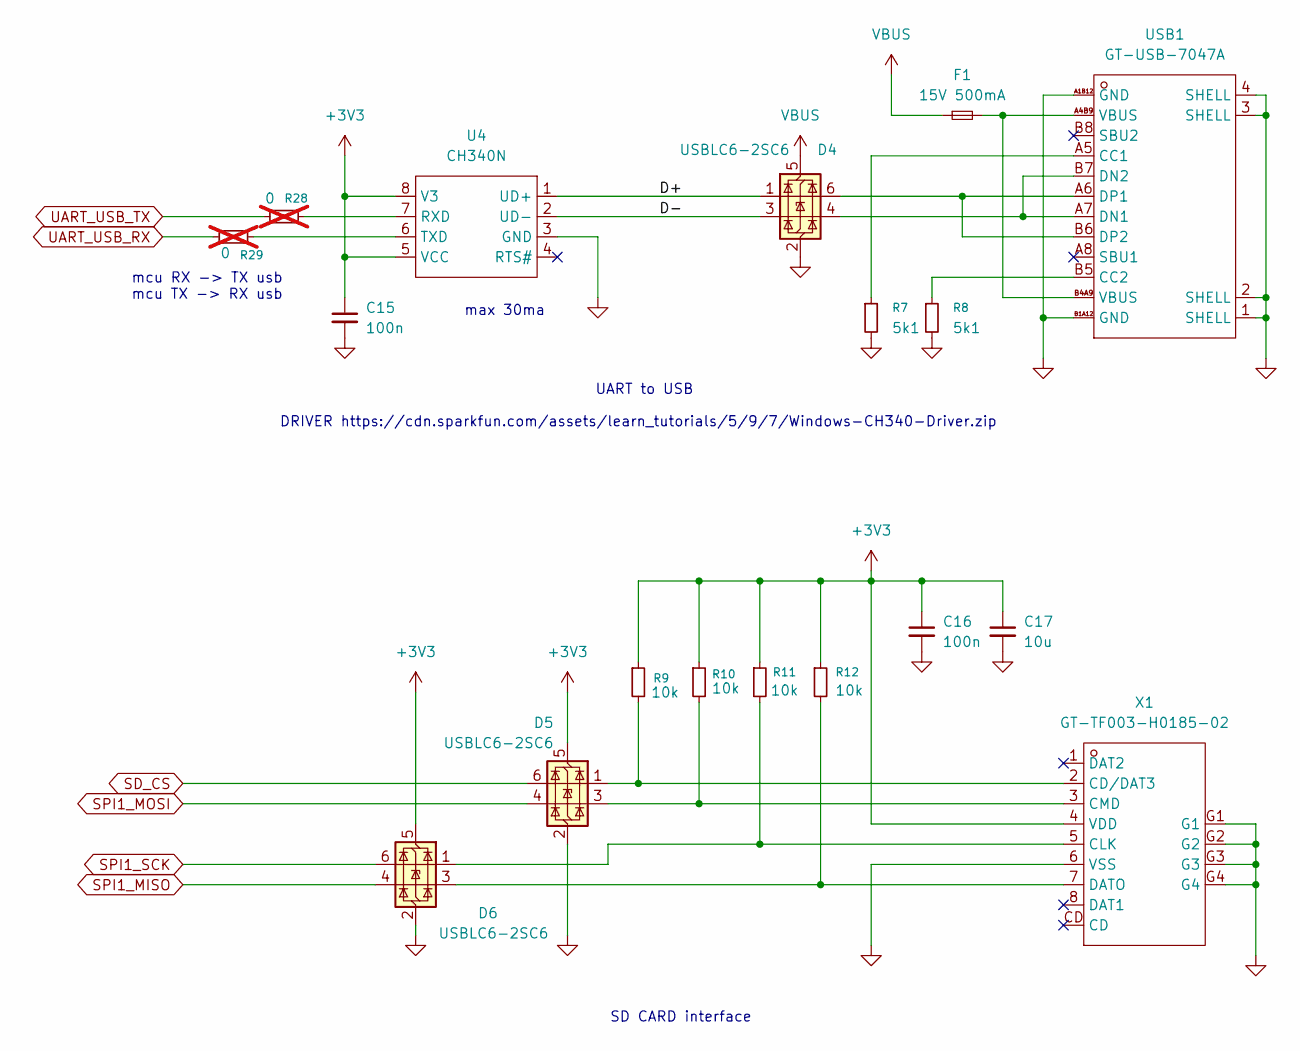
[picture p51: schematic USB.kicad_sch, 2CH CAN Logger]

Parts:
C15, C16: 100n; C0603
C17: 10u; C0805
D4, D5, D6: USBLC6-2SC6; SOT-23-6_L2.9-W1.6-P0.95-LS2.8-BL; Manufacturer Part USBLC6-2SC6; LCSC Part Name 单向ESD
F1: 15V 500mA; F1812; Manufacturer Part SMD1812P050TF; LCSC Part Name 15V 500mA 1812自恢复
R7, R8: 5k1; R0603
R9, R10, R11, R12: 10k; R0603
R28, R29: 0; R0603; not fitted
U4: CH340N; SOP-8_L4.9-W3.9-P1.27-LS6.0-BL; Manufacturer Part CH340N; LCSC Part Name USB2.0芯片CH340
USB1: GT-USB-7047A; USB-C-SMD_GT-USB-7047A; Manufacturer Part GT-USB-7047A; LCSC Part Name Type-C 母 卧贴
X1: GT-TF003-H0185-02; SIM-SMD_GT-TF003-H0185-02; Manufacturer Part GT-TF003-H0185-02; LCSC Part Name 自弹式 MicroSD卡(TF卡) 卡座

Connections:
+3V3: C15.1, C16.1, C17.1, D5.5 (VBUS), D6.5 (VBUS), R9.1, R10.1, R11.1, R12.1, U4.5 (VCC), U4.8 (V3), X1.4 (VDD); also elsewhere on the board
/USB_SDCARD/D+: D4.1 (I/O1), U4.1 (UD+)
/USB_SDCARD/D-: D4.3 (I/O2), U4.2 (UD-)
GND: C15.2, C16.2, C17.2, D4.2 (GND), D5.2 (GND), D6.2 (GND), R7.2, R8.2, U4.3 (GND), USB1.1 (SHELL), USB1.2 (SHELL), USB1.3 (SHELL), USB1.4 (SHELL), USB1.A1B12 (GND), USB1.B1A12 (GND), X1.6 (VSS), X1.G1, X1.G2, X1.G3, X1.G4; also elsewhere on the board
unnamed: F1.2, USB1.A4B9 (VBUS), USB1.B4A9 (VBUS)
unnamed: R28.2, U4.7 (RXD)
unnamed: R29.2, U4.6 (TXD)
unnamed: R7.1, USB1.A5 (CC1)
unnamed: R8.1, USB1.B5 (CC2)
unnamed: D4.4 (I/O2), USB1.A7 (DN1), USB1.B7 (DN2)
unnamed: D4.6 (I/O1), USB1.A6 (DP1), USB1.B6 (DP2)
unnamed: D5.1 (I/O1), R9.2, X1.2 (CD/DAT3)
unnamed: D6.1 (I/O1), R11.2, X1.5 (CLK)
unnamed: D5.3 (I/O2), R10.2, X1.3 (CMD)
unnamed: D6.3 (I/O2), R12.2, X1.7 (DATO)
SD_CS: D5.6 (I/O1); also elsewhere on the board
SPI1_MISO: D6.4 (I/O2); also elsewhere on the board
SPI1_MOSI: D5.4 (I/O2); also elsewhere on the board
SPI1_SCK: D6.6 (I/O1); also elsewhere on the board
UART_USB_RX: R29.1; also elsewhere on the board
UART_USB_TX: R28.1; also elsewhere on the board
VBUS: D4.5 (VBUS), F1.1; also elsewhere on the board

Notes on the sheet:
SD CARD interface
DRIVER https://cdn.sparkfun.com/assets/learn_tutorials/5/9/7/Windows-CH340-Driver.zip
max 30ma
mcu RX -> TX usb mcu TX -> RX usb
UART to USB

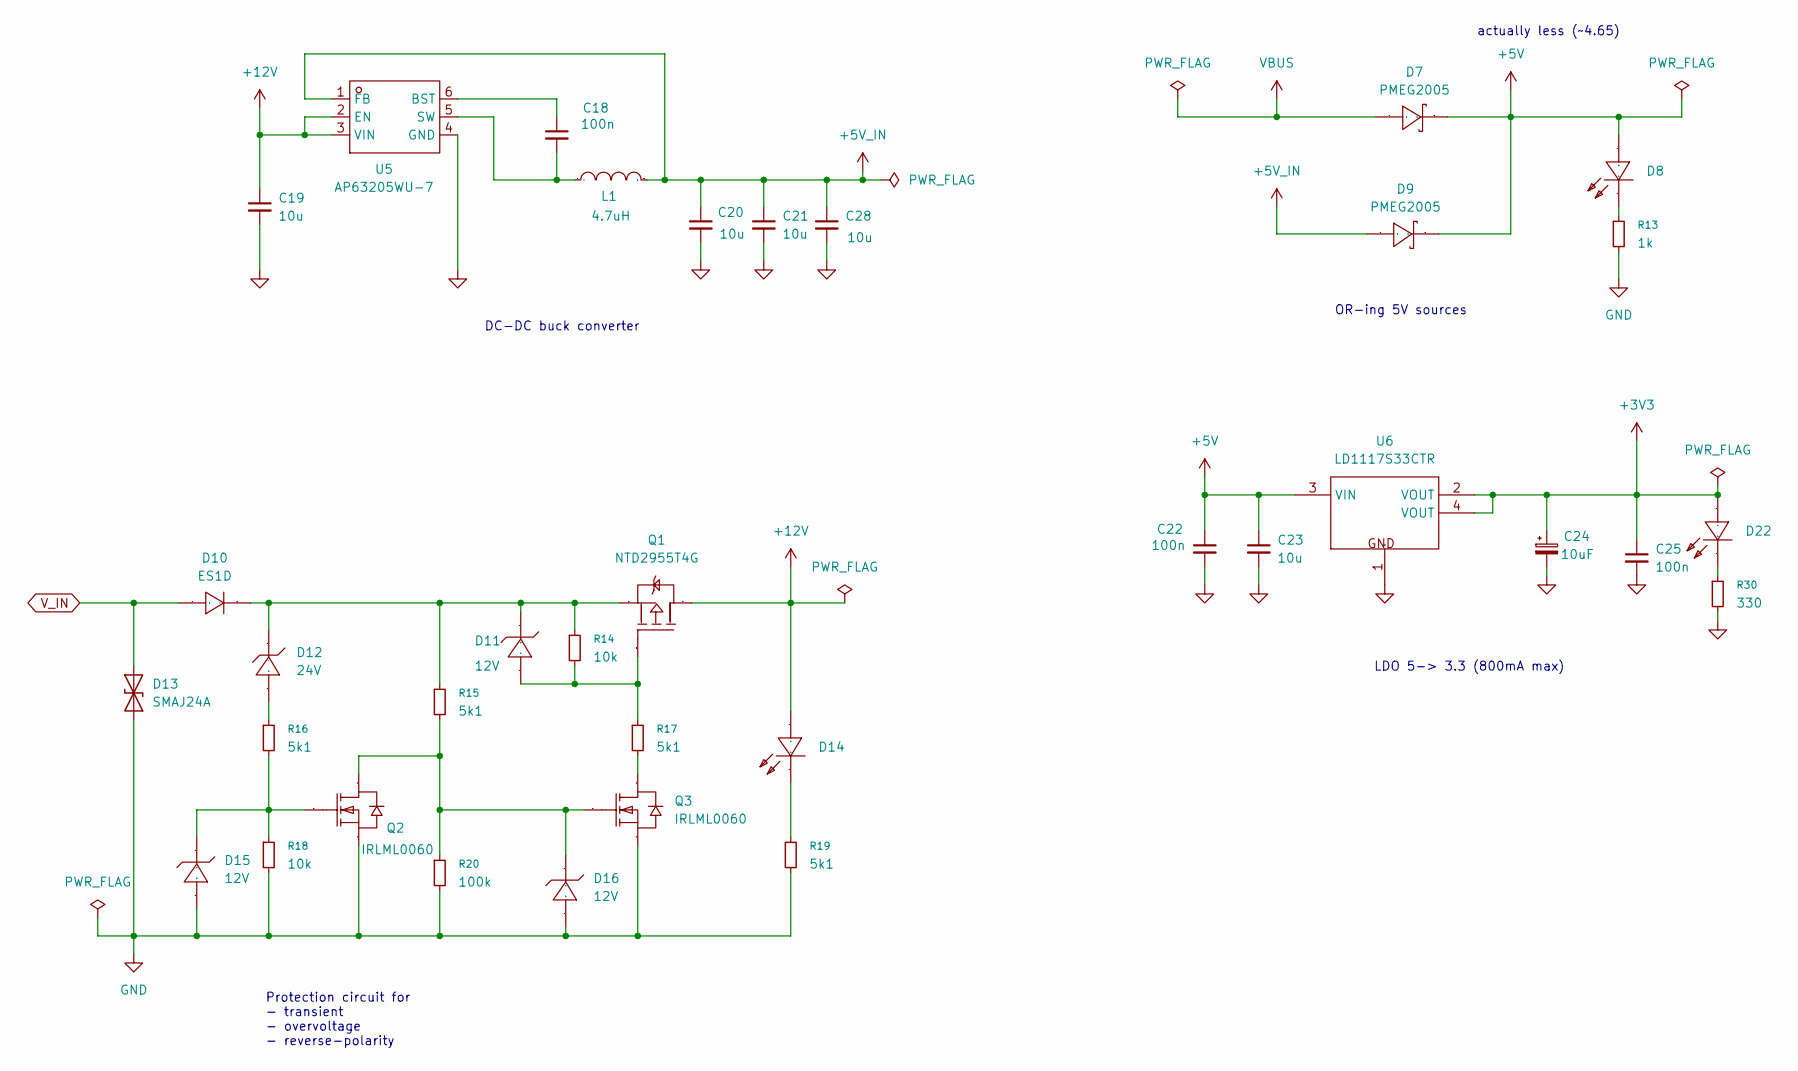
[picture p52: schematic POWER.kicad_sch, 2CH CAN Logger]

Parts:
C18, C22, C25: 100n; C0603
C19, C20, C21, C23, C28: 10u; C0805
C24: 10uF; CASE-A_3216; Manufacturer Part TAJA106K010RNJ; LCSC Part Name 10uF ±10% 10V
D7, D9: PMEG2005; SOD-123_L2.8-W1.8-LS3.7-RD; Manufacturer Part PMEG2005EGWX; LCSC Part Name 电压:20V 电流:500mA
D8, D14, D22: LED0603-RD; Manufacturer Part KT-0603R; LCSC Part Name 0603 红灯 高亮
D10: ES1D; SMA_L4.3-W2.6-LS5.2-RD; Manufacturer Part ES1D-E3/61T; LCSC Part Name 耐压:200V 电流:1A 反向恢复时间：15ns
D11, D15, D16: 12V; SOD-123_L2.8-W1.8-LS3.7-RD; Manufacturer Part MMSZ12T1G; LCSC Part Name MMSZ12T1G
D12: 24V; SOD-123_L2.8-W1.8-LS3.7-RD; Manufacturer Part MMSZ5252BT1G; LCSC Part Name MMSZ5252BT1G
D13: SMAJ24A; SMA_L4.4-W2.6-LS5.0-RD; Manufacturer Part SMAJ24A; LCSC Part Name 单向TVS 24V截止 10.3A峰值脉冲
L1: 4.7uH; IND-SMD_L4.4-W4.2-A; Manufacturer Part 0420CDMCCDS-4R7MC; LCSC Part Name 4.7uH ±20% 3A
Q1: NTD2955T4G; TO-252-2_L6.6-W6.1-P4.57-LS9.9-TL-CW; Manufacturer Part NTD2955T4G; LCSC Part Name 1个P沟道 耐压:60V 电流:12A
Q2, Q3: IRLML0060; SOT-23-3_L2.9-W1.6-P1.90-LS2.8-BR; Manufacturer Part IRLML0060TRPBF; LCSC Part Name 1个N沟道 耐压:60V 电流:2.7A
R13: 1k; R0603
R14, R18: 10k; R0603
R15, R16, R17, R19: 5k1; R0603
R20: 100k; R0603
R30: 330; R0603
U5: AP63205WU-7; TSOT-23-6_L2.9-W1.6-P0.95-LS2.8-BL; Manufacturer Part AP63205WU-7; LCSC Part Name 3.8V至32V输入、2A低静态电流同步降压转换器，增强EMI抑制
U6: LD1117S33CTR; SOT-223-4_L6.5-W3.5-P2.30-LS7.0-BR; Manufacturer Part LD1117S33CTR; LCSC Part Name 可调与固定低压降正电压稳压器

Connections:
+3V3: C24.1, C25.1, D22.2 (A), U6.2 (VOUT), U6.4 (VOUT); also elsewhere on the board
+5V: C22.1, C23.1, D7.1 (A), D8.2 (A), D9.1 (A), U6.3 (VIN); also elsewhere on the board
+5V_IN: C20.1, C21.1, C28.1, D9.2 (K), L1.1, U5.1 (FB)
+12V: C19.1, D14.2 (A), Q1.2 (D), U5.2 (EN), U5.3 (VIN)
GND: C19.2, C20.2, C21.2, C22.2, C23.2, C24.2, C25.2, C28.2, D13.2 (A2), D15.2 (A), D16.2 (A), Q2.2 (S), Q3.2 (S), R13.2, R18.2, R19.2, R20.2, R30.2, U5.4 (GND), U6.1 (GND); also elsewhere on the board
unnamed: D8.1 (K), R13.1
unnamed: D10.1 (C), D11.1 (K), D12.1 (C), Q1.3 (S), R14.1, R15.1
unnamed: D11.2 (A), Q1.1 (G), R14.2, R17.1
unnamed: D12.2 (A), R16.1
unnamed: D14.1 (K), R19.1
unnamed: D15.1 (K), Q2.1 (G), R16.2, R18.1
unnamed: D16.1 (K), Q2.3 (D), Q3.1 (G), R15.2, R20.1
unnamed: D22.1 (K), R30.1
unnamed: Q3.3 (D), R17.2
unnamed: C18.1, U5.6 (BST)
unnamed: C18.2, L1.2, U5.5 (SW)
VBUS: D7.2 (K); also elsewhere on the board
V_IN: D10.2 (A), D13.1 (A1); also elsewhere on the board

Notes on the sheet:
LDO 5-> 3.3 (800mA max)
OR-ing 5V sources
DC-DC buck converter
actually less (~4.65)
Protection circuit for - transient - overvoltage - reverse-polarity

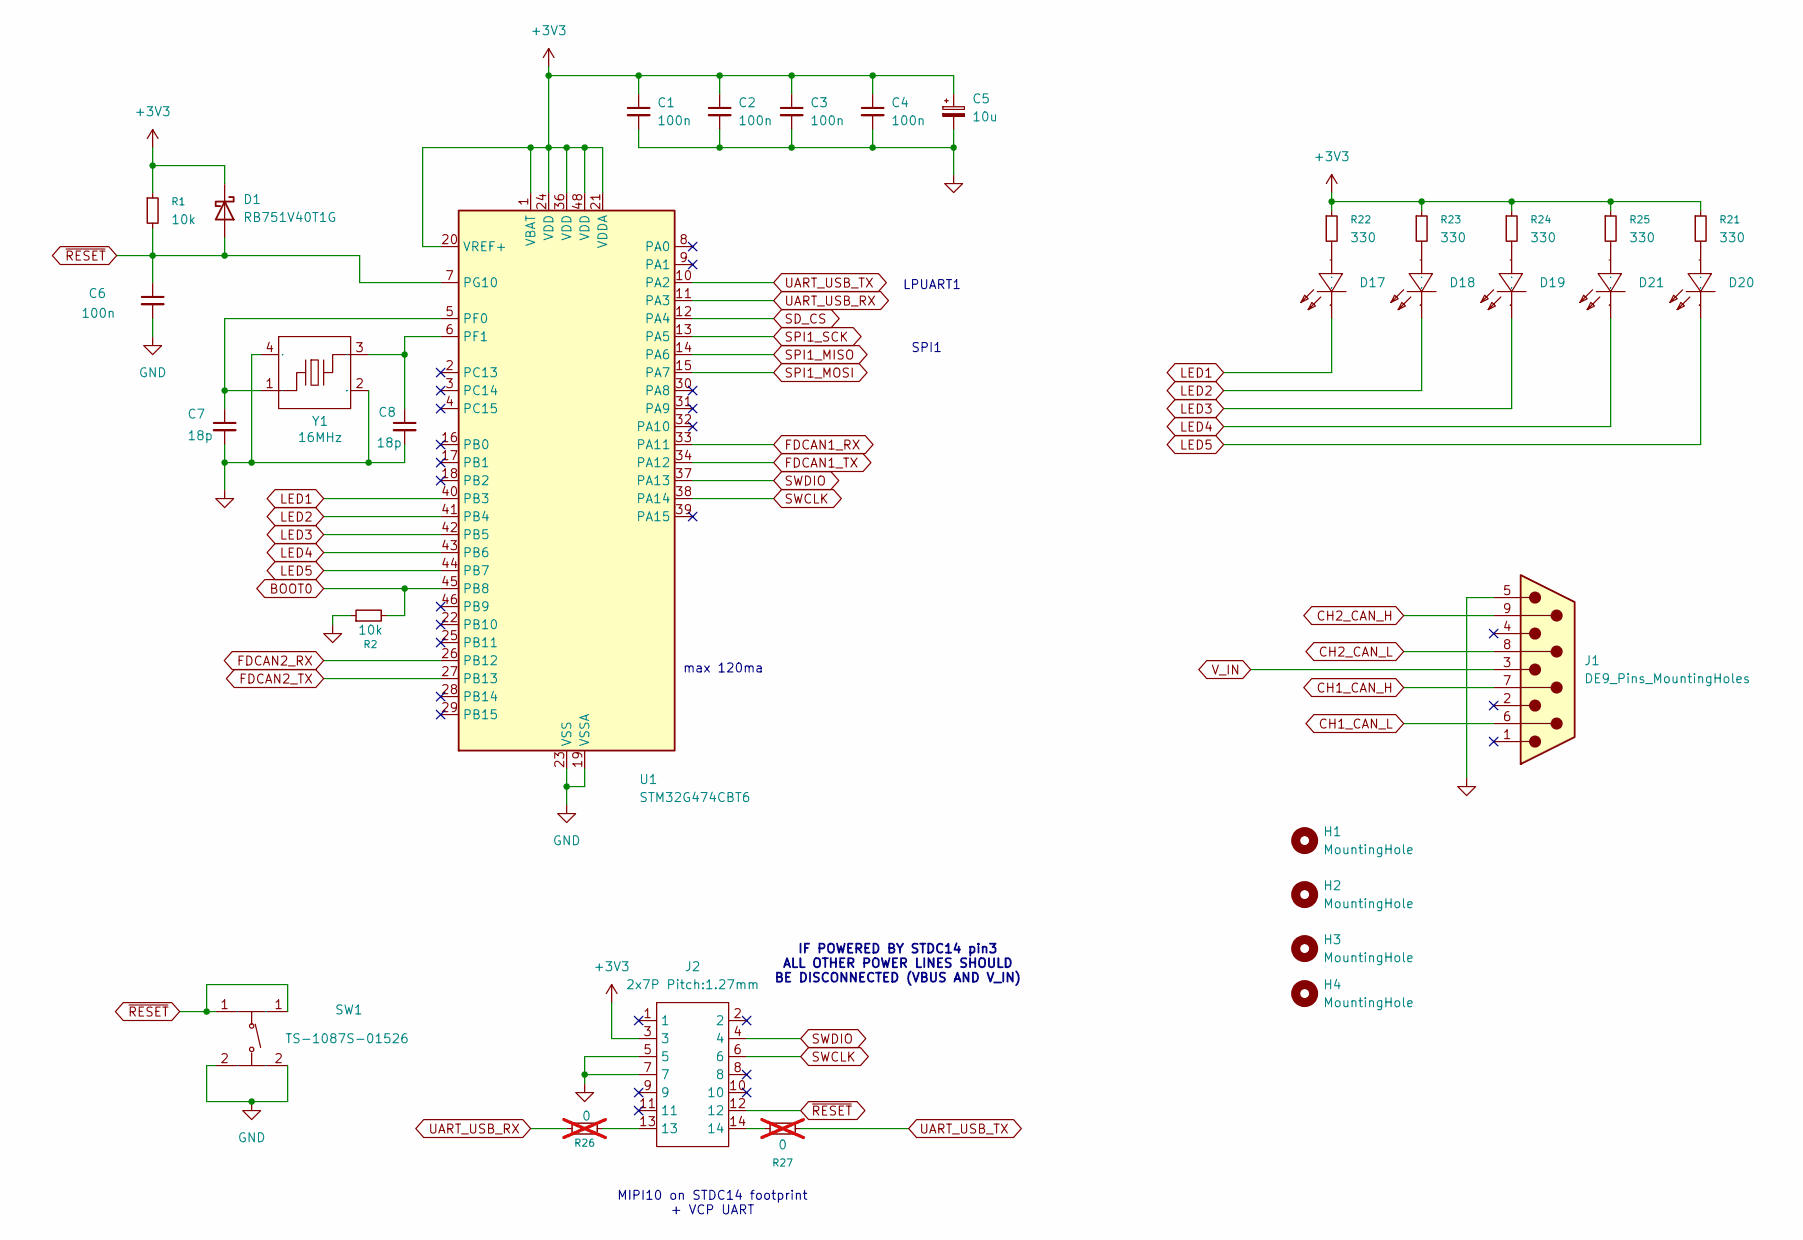
[picture p53: schematic MCU.kicad_sch, 2CH CAN Logger]

Parts:
C1, C2, C3, C4, C6: 100n; C0603
C5: 10u; C0805
C7, C8: 18p; C0603
D1: RB751V40T1G; SOD-323_L1.8-W1.3-LS2.5-RD; Manufacturer Part RB751V40T1G; LCSC Part Name 电压:30V 电流:30mA
D17, D18, D19, D20, D21: LED0603-RD; Manufacturer Part KT-0603R; LCSC Part Name 0603 红灯 高亮
H1, H2, H3, H4: MountingHole; MountingHole_2.7mm_M2.5_Pad_TopBottom
J1: DE9_Pins_MountingHoles; DSUB-9_Pins_EdgeMount_P2.77mm
J2: 2x7P Pitch:1.27mm; HDR-SMD_14P-P1.27_HX-PZ1.27-2X7P-TP; Manufacturer Part HX PZ1.27-2x7P TP; LCSC Part Name 2x7P 间距:1.27mm 方针 立贴
R1, R2: 10k; R0603
R21, R22, R23, R24, R25: 330; R0603
R26, R27: 0; R0603; not fitted
SW1: TS-1087S-01526; SW-SMD_L5.2-W5.2-P3.70-LS6.4; Manufacturer Part TS-1087S-01526; LCSC Part Name 5.2*5.2*1.5mm 立贴 轻触开关
U1: STM32G474CBT6; LQFP-48_L7.0-W7.0-P0.50-LS9.0-BL; Manufacturer Part STM32G474CBT6; LCSC Part Name STM32G474CBT6
Y1: 16MHz; CRYSTAL-SMD_4P-L3.2-W2.5-BL_SIT8008BI; Manufacturer Part CF4016M00009001; LCSC Part Name 16MHz ±10ppm 9pF

Connections:
+3V3: C1.1, C2.1, C3.1, C4.1, C5.1, D1.1 (K), J2.3, R1.1, R21.1, R22.1, R23.1, R24.1, R25.1, U1.1 (VBAT), U1.20 (VREF+), U1.21 (VDDA), U1.24 (VDD), U1.36 (VDD), U1.48 (VDD); also elsewhere on the board
BOOT0: R2.2, U1.45 (PB8)
CH1_CAN_H: J1.7; also elsewhere on the board
CH1_CAN_L: J1.6; also elsewhere on the board
CH2_CAN_H: J1.9; also elsewhere on the board
CH2_CAN_L: J1.8; also elsewhere on the board
FDCAN1_RX: U1.33 (PA11); also elsewhere on the board
FDCAN1_TX: U1.34 (PA12); also elsewhere on the board
FDCAN2_RX: U1.26 (PB12); also elsewhere on the board
FDCAN2_TX: U1.27 (PB13); also elsewhere on the board
GND: C1.2, C2.2, C3.2, C4.2, C5.2, C6.2, C7.2, C8.2, J1.5, J2.5, J2.7, R2.1, SW1.2, U1.19 (VSSA), U1.23 (VSS), U1.35 (VSS), U1.47 (VSS), Y1.2 (GND), Y1.4 (GND); also elsewhere on the board
LED1: D17.1 (K), U1.40 (PB3)
LED2: D18.1 (K), U1.41 (PB4)
LED3: D19.1 (K), U1.42 (PB5)
LED4: D21.1 (K), U1.43 (PB6)
LED5: D20.1 (K), U1.44 (PB7)
unnamed: D17.2 (A), R22.2
unnamed: D18.2 (A), R23.2
unnamed: D19.2 (A), R24.2
unnamed: D20.2 (A), R21.2
unnamed: D21.2 (A), R25.2
unnamed: J2.13, R26.2
unnamed: J2.14, R27.1
unnamed: C7.1, U1.5 (PF0), Y1.1
unnamed: C8.1, U1.6 (PF1), Y1.3
SD_CS: U1.12 (PA4); also elsewhere on the board
SPI1_MISO: U1.14 (PA6); also elsewhere on the board
SPI1_MOSI: U1.15 (PA7); also elsewhere on the board
SPI1_SCK: U1.13 (PA5); also elsewhere on the board
SWCLK: J2.6, U1.38 (PA14)
SWDIO: J2.4, U1.37 (PA13)
UART_USB_RX: R26.1, U1.11 (PA3); also elsewhere on the board
UART_USB_TX: R27.2, U1.10 (PA2); also elsewhere on the board
V_IN: J1.3; also elsewhere on the board
~RESET: C6.1, D1.2 (A), J2.12, R1.2, SW1.1, U1.7 (PG10)

Notes on the sheet:
MIPI10 on STDC14 footprint + VCP UART
LPUART1
max 120ma
SPI1
IF POWERED BY STDC14 pin3 ALL OTHER POWER LINES SHOULD BE DISCONNECTED (VBUS AND V_IN)

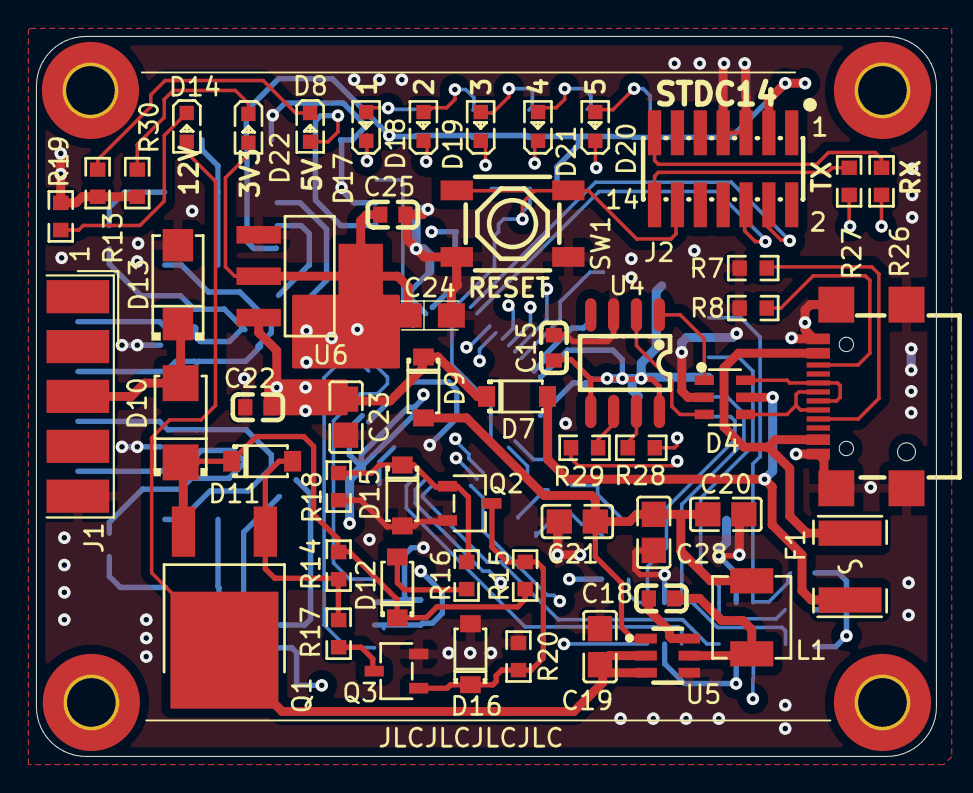
[picture p54: board canlogger.kicad_pcb from above]

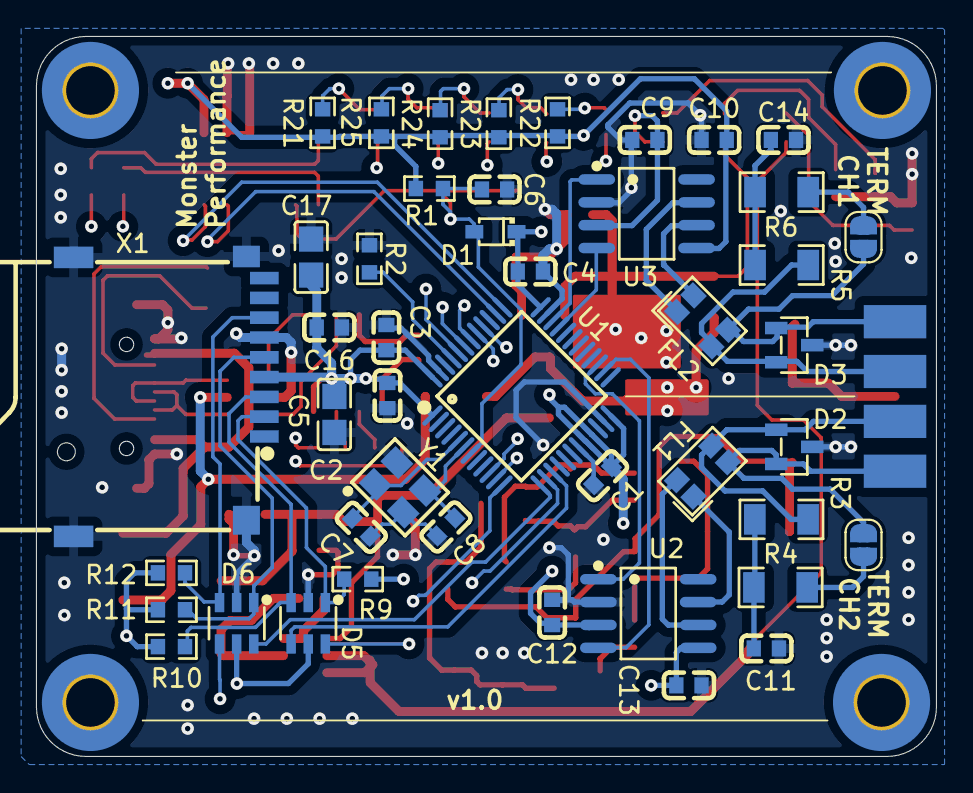
[picture p55: board canlogger.kicad_pcb from below]

Board: 4 copper layers, 50.0 x 40.0 mm, 103 parts (45 on the bottom side), 71 nets.
