alkaliu/CanLogger2CH_stm32/(commit log)

2025-10-31 Add v1.0 files
    [C0603_L1.6-W0.8-H0.8.step, C0805_L2.0-W1.3-H1.3.step, C1206_L3.2-W1.6-H1.3.step, CAN.kicad_sch, CASE-A_3216.step, CRYSTAL-SMD_4P-L3.2-W2.5-BL_SIT8008BI.step, DLW31SN222SQ2L--3DModel-STEP-1.STEP, DSUB-TH_DMR-9P-M-LI.step]
2025-11-03 Fix SPI pins add 3.3v led
    [MCU.kicad_sch, POWER.kicad_sch, USB.kicad_sch, canlogger.kicad_pcb]
2025-11-03 change 2x22u to 3x10u plot all order jlcpcb + lcsc
    [CAN.kicad_sch, LCSC__WM2511040164_20251104051059.csv, MCU.kicad_sch, POWER.kicad_sch, USB.kicad_sch, canlogger.kicad_pcb, canlogger_bom_lcsc.csv]
